ackom-a-o/stm32f446-development-board/README.md

# STM32F446 Development Board

A custom, USB-powered development board for sensor and control experiments, built around the **STM32F446ZET6**. This project follows an embedded hardware design from component selection and PCB layout through assembly preparation, firmware and bench validation.

**Current milestone: prototype fabrication preparation.** The corrected design, fabrication exports and assembly data are published below. Hardware is not yet bench-tested; final assembler production-file approval and physical validation remain open.

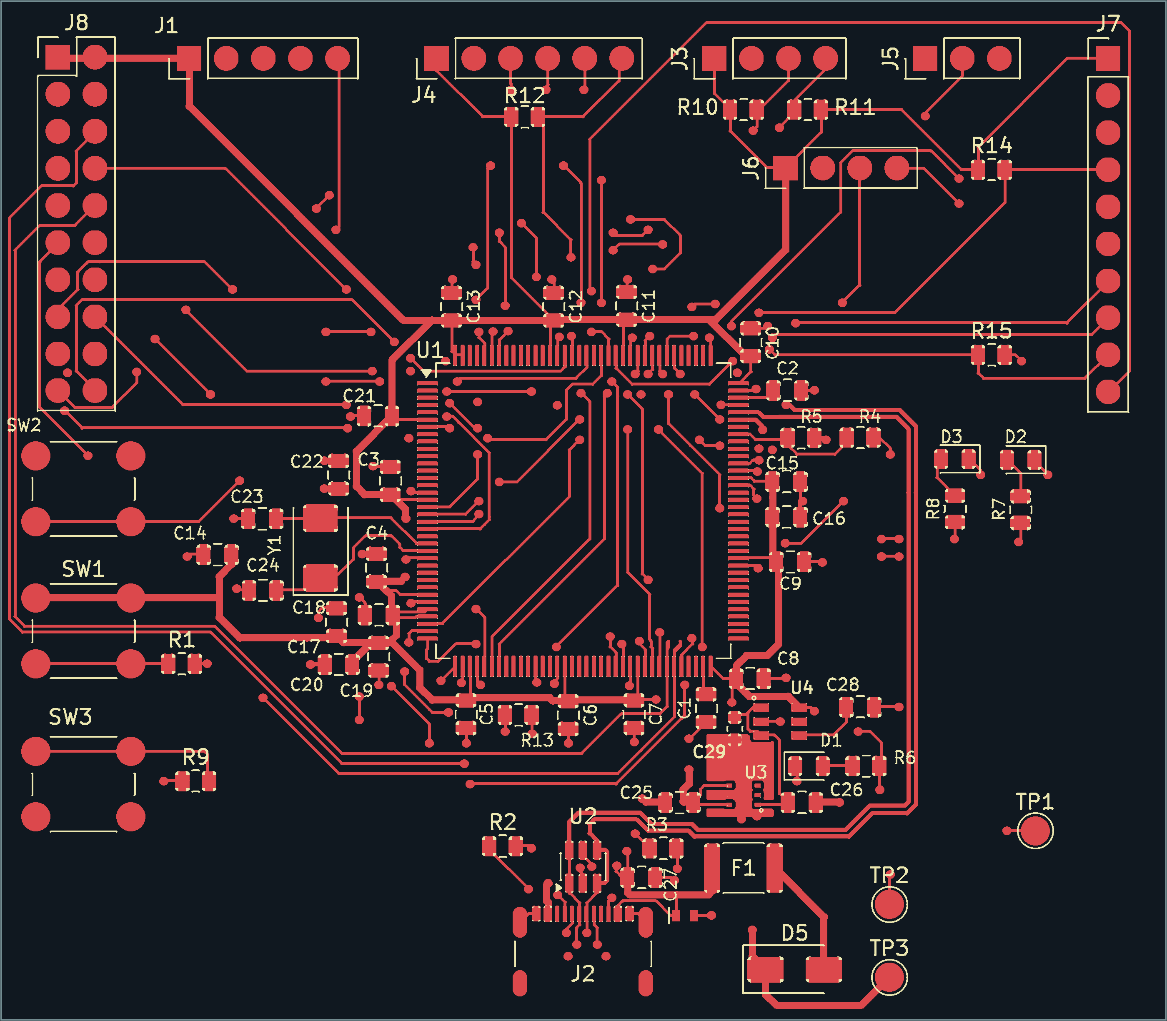
[picture p1: docs/images/pcb-top.png]
Current PCB top copper and silkscreen


*Composed from the current fabrication Gerbers. Top copper and silkscreen only; drill holes are not depicted. This is a design view, not an assembled-board photograph.*

[Schematic PDF](docs/schematic.pdf) · [Engineering review](docs/engineering-review.md) · [Validation evidence](docs/validation.md) · [Manufacturing package](manufacturing/prototype-r3/) · [First power-up](docs/bring-up.md)

## What the board provides

| Area | Implementation |
|---|---|
| MCU | STM32F446ZET6, Arm Cortex-M4, LQFP-144 |
| PCB | 80 × 70 mm, four copper layers, nominal 1.6 mm |
| Power | USB 5 V → protection → TPS7A2533 regulator → TPS22918 load switch → 3.3 V |
| Connectivity | USB 2.0 full-speed device, SPI, I²C, UART, analog and GPIO headers |
| CAN expansion | Classical CAN 2.0B on J7: PD0/RX and PD1/TX; requires an external 3.3 V logic-compatible transceiver |
| Debug | External SWD probe through a custom five-pin header |
| Clock | 8 MHz crystal |
| User controls | Three pushbuttons and three indicator LEDs |

USB host operation, USB Power Delivery and motor-power delivery are outside the current scope. The load switch controls rail startup; it is not a programmable current limiter.

```mermaid
flowchart LR
    USB[USB-C 5 V] --> Protection[Fuse and series diode]
    Protection --> LDO[TPS7A2533 regulator]
    LDO --> Switch[TPS22918 load switch]
    Switch --> Rail[3.3 V MCU and headers]
    Host[USB host data] <--> ESD[USBLC6 protection]
    ESD <--> MCU[STM32F446]
    Probe[External SWD probe] <--> MCU
    MCU <--> IO[SPI / I2C / UART / GPIO]
    MCU <--> CANHeader[J7: PD0 RX / PD1 TX]
    CANHeader <--> Transceiver[External CAN transceiver - required]
    Transceiver <--> CANBus[CANH / CANL bus]
```

CAN uses the MCU's existing CAN1 controller through J7 pin 3 (PD0/CAN1_RX) and pin 4 (PD1/CAN1_TX), configured as AF9. The transceiver and bus termination are external to this PCB. This is Classical CAN, not CAN FD, and firmware/link testing is pending.

## Engineering work behind the layout

The layout was reviewed against MCU and power-component datasheets, ST's USB hardware guidance and published signal-integrity advice. Checks covered electrical connectivity, local bypassing, ground return paths, USB geometry, reset/crystal placement, sourcing, footprint fit and assembly orientation. The [engineering review](docs/engineering-review.md) records the reasoning, corrections, references and remaining limits.

- **Reset routing:** moving C22 reduced its MCU reset route from **19.45 mm to 13.41 mm**, about 31%. The [before/after comparison](docs/design-decisions.md#reset-layout-iteration) records the improvement and remaining compromise.
- **Power margin:** a **250 mA total design budget** was screened against regulator dropout and dissipation. It remains conditional until load and thermal measurements establish the board's operating envelope.
- **Local bypassing:** C29 adds a dedicated 1 µF capacitor at the TPS22918 input instead of relying only on the regulator's more distant output capacitor.
- **Ground return:** a short PG9 inner-layer crossing was moved to the top layer to restore local ground beneath SWDIO. Ground stitching was retained; a geometric screen found no missing reference samples along the checked outer-layer routes.
- **Routing corners:** the remaining ordinary PF6 right-angle bend was replaced with chamfered routing. The saved-board audit found zero ordinary track-to-track 90° bends within its stated scope. [Why prefer 45° bends?](docs/engineering-review.md#routing-corners-why-prefer-45-degrees) They reduce abrupt geometry changes; a right angle alone does not prove a signal will fail.
- **Assembly data:** the supplier preview exposed header and chip rotation mismatches. Corrections were put into the placement file, uploaded and checked after a full quote reload.

Peer feedback and AI-assisted checks supported these iterations. Bench measurements will be reported separately from calculations and software checks.

## Evidence and next milestone

Recorded checks on **22 October 2026** report **0 ERC issues, 0 DRC violations, 0 unconnected items and 0 schematic parity issues**, with no ignored checks or current exclusions. The published inventory contains **66 assembly references**, plus three PCB test points. [Validation evidence](docs/validation.md) links the source hashes, reports and geometric checks; these do not establish measured hardware performance.

The fabricator has confirmed the nominal **JLC04161H-7628** construction used as the design basis. Next: approve final production files and bring up the prototype. The [bring-up checklist](docs/bring-up.md) starts with inspection, shorts and power rails, then SWD/reset, clock startup, GPIO and USB. Every physical test in the [test log](docs/test-log.md) remains **not tested**. Firmware will be added when implementation begins.

## Explore the design

Open [`stm32.kicad_pro`](stm32.kicad_pro) in **KiCad 10**, with its standard libraries installed.

The [four-sheet schematic](docs/schematic.pdf) separates power, USB/debug/clock, peripheral interfaces and expansion. The MCU uses eight symbol units so that supply pins and GPIO ports can be reviewed separately. Named signals connect sheets; pin numbers retain their physical package mapping.

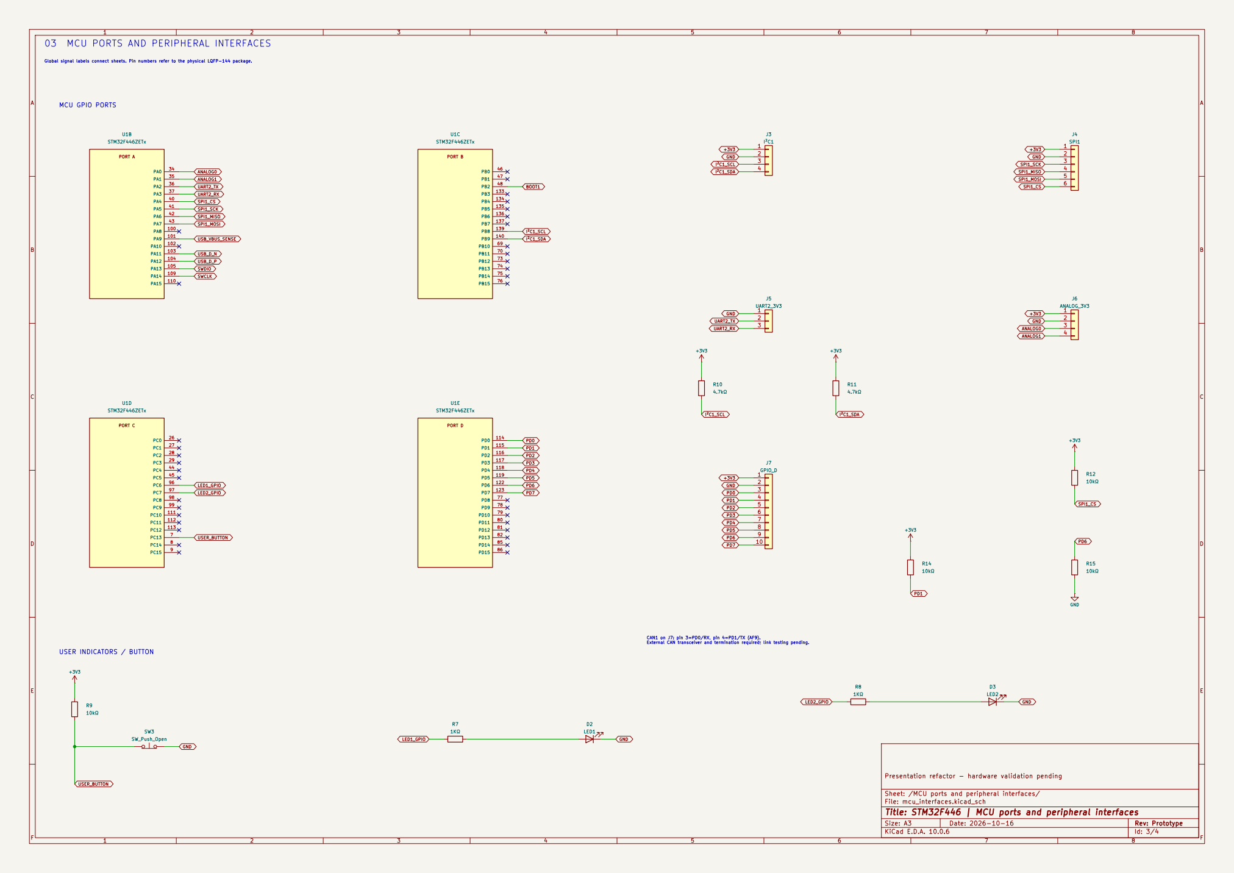
[picture p2: docs/images/schematic-interfaces.png]
MCU ports and peripheral interface schematic


*Sheet 3 of 4. The earlier readability refactor preserved its then-current 68 physical references and all 135 nets; [historical comparison evidence](docs/checks/schematic-refactor.json) records unchanged PCB geometry for that refactor. The subsequent C29 addition brings the current physical-reference count to 69.*

| Files | Purpose |
|---|---|
| `stm32.kicad_sch` | Root sheet: power path and MCU supplies |
| `usb_debug_clock.kicad_sch` | USB, clock, reset, boot and SWD |
| `mcu_interfaces.kicad_sch`, `gpio_expansion.kicad_sch` | MCU ports, peripheral headers and expansion |
| `stm32.kicad_pcb` | Routed four-layer PCB |
| `stm32.kicad_dru` | Project design rules |
| `STM32_Custom.pretty`, `STM32_Power.kicad_sym`, `STM32_MCU.kicad_sym` | Local footprints, power symbols and split MCU symbol |
| `fp-lib-table`, `sym-lib-table` | Project-relative library configuration |
| `docs/` | Schematic export, design decisions, part inventory and validation evidence |

Local libraries are included. The empty `Library.pretty` directory is retained for the existing project library table. The [prototype-r3 package](manufacturing/prototype-r3/) contains Gerbers/drills, BOM, supplier-adjusted placement data and file hashes. It is an unvalidated prototype package, not a production-qualified release. Placement rotations are supplier-specific; another assembler must check its own conventions.

## References and licensing

[STM32F446 datasheet](https://www.st.com/resource/en/datasheet/stm32f446ze.pdf) · [TPS7A25 datasheet](https://www.ti.com/lit/ds/symlink/tps7a25.pdf) · [TPS22918 datasheet](https://www.ti.com/lit/ds/symlink/tps22918.pdf)

A project hardware/documentation license has not yet been selected. No explicit open-source license is currently granted. Third-party assets remain subject to their respective licenses.
