ackom-a-o/stm32f446-development-board/manufacturing/prototype-r3/BOM.csv

Comment | Designator | Footprint | LCSC Part #
2.2uF | C1 | Capacitor_SMD:C_0805_2012Metric | C16195008
2.2uF | C2 | Capacitor_SMD:C_0805_2012Metric | C16195008
100nF | C3 | Capacitor_SMD:C_0805_2012Metric | C49678
100nF | C4 | Capacitor_SMD:C_0805_2012Metric | C49678
100nF | C5 | Capacitor_SMD:C_0805_2012Metric | C49678
100nF | C6 | Capacitor_SMD:C_0805_2012Metric | C49678
100nF | C7 | Capacitor_SMD:C_0805_2012Metric | C49678
100nF | C8 | Capacitor_SMD:C_0805_2012Metric | C49678
100nF | C9 | Capacitor_SMD:C_0805_2012Metric | C49678
100nF | C10 | Capacitor_SMD:C_0805_2012Metric | C49678
100nF | C11 | Capacitor_SMD:C_0805_2012Metric | C49678
100nF | C12 | Capacitor_SMD:C_0805_2012Metric | C49678
100nF | C13 | Capacitor_SMD:C_0805_2012Metric | C49678
4.7uF | C14 | Capacitor_SMD:C_0805_2012Metric | C1779
100nF | C15 | Capacitor_SMD:C_0805_2012Metric | C49678
1µF | C16 | Capacitor_SMD:C_0805_2012Metric | C28323
100nF | C17 | Capacitor_SMD:C_0805_2012Metric | C49678
1µF | C18 | Capacitor_SMD:C_0805_2012Metric | C28323
100nF | C19 | Capacitor_SMD:C_0805_2012Metric | C49678
1µF | C20 | Capacitor_SMD:C_0805_2012Metric | C28323
100nF | C21 | Capacitor_SMD:C_0805_2012Metric | C49678
100nF | C22 | Capacitor_SMD:C_0805_2012Metric | C49678
22pF C0G | C23 | Capacitor_SMD:C_0805_2012Metric | C1804
22pF C0G | C24 | Capacitor_SMD:C_0805_2012Metric | C1804
2.2uF25VX7R | C25 | Capacitor_SMD:C_0805_2012Metric | C16195008
2.2uF 25V X7R | C26 | Capacitor_SMD:C_0805_2012Metric | C16195008
100nF | C27 | Capacitor_SMD:C_0805_2012Metric | C49678
4.7nF | C28 | Capacitor_SMD:C_0805_2012Metric | C107153
1µF | C29 | Capacitor_SMD:C_0603_1608Metric | C29936
Green | D1 | LED_SMD:LED_0805_2012Metric | C2297
LED1 | D2 | LED_SMD:LED_0805_2012Metric | C2295
LED2 | D3 | LED_SMD:LED_0805_2012Metric | C2295
ESDA7P120-1U1M | D4 | STM32_Custom:ESDA7P60-1U1M | C2969802
SS14 | D5 | Diode_SMD:D_SMA | C2480
500mA | F1 | Fuse:Fuse_1812_4532Metric | C17313
SWD | J1 | Connector_PinHeader_2.54mm:PinHeader_1x05_P2.54mm_Vertical | C55629812
USB_C_Receptacle_USB2.0_16P | J2 | STM32_Custom:USB_C_Receptacle_USB4105_JLC | C5184243
I²C1 | J3 | Connector_PinHeader_2.54mm:PinHeader_1x04_P2.54mm_Vertical | C492403
SPI1 | J4 | Connector_PinHeader_2.54mm:PinHeader_1x06_P2.54mm_Vertical | C5142852
UART2_3V3 | J5 | Connector_PinHeader_2.54mm:PinHeader_1x03_P2.54mm_Vertical | C18213718
ANALOG_3V3 | J6 | Connector_PinHeader_2.54mm:PinHeader_1x04_P2.54mm_Vertical | C492403
GPIO_D | J7 | Connector_PinHeader_2.54mm:PinHeader_1x10_P2.54mm_Vertical | C492409
EXPANSION_3V3 | J8 | Connector_PinHeader_2.54mm:PinHeader_2x10_P2.54mm_Vertical | C492427
10kΩ | R1 | Resistor_SMD:R_0805_2012Metric | C17414
5.1kΩ 1% | R2 | Resistor_SMD:R_0805_2012Metric | C27834
5.1kΩ 1% | R3 | Resistor_SMD:R_0805_2012Metric | C27834
33kΩ,1% | R4 | Resistor_SMD:R_0805_2012Metric | C17633
82kΩ,1% | R5 | Resistor_SMD:R_0805_2012Metric | C17840
1KΩ | R6 | Resistor_SMD:R_0805_2012Metric | C17513
1KΩ | R7 | Resistor_SMD:R_0805_2012Metric | C17513
1KΩ | R8 | Resistor_SMD:R_0805_2012Metric | C17513
10kΩ | R9 | Resistor_SMD:R_0805_2012Metric | C17414
4.7kΩ | R10 | Resistor_SMD:R_0805_2012Metric | C17673
4.7kΩ | R11 | Resistor_SMD:R_0805_2012Metric | C17673
10kΩ | R12 | Resistor_SMD:R_0805_2012Metric | C17414
10kΩ | R13 | Resistor_SMD:R_0805_2012Metric | C17414
10kΩ | R14 | Resistor_SMD:R_0805_2012Metric | C17414
10kΩ | R15 | Resistor_SMD:R_0805_2012Metric | C17414
SW_Push_Open | SW1 | Button_Switch_THT:SW_PUSH_6mm_H4.3mm | C93157
SW_Push_Open | SW2 | Button_Switch_THT:SW_PUSH_6mm_H4.3mm | C93157
SW_Push_Open | SW3 | Button_Switch_THT:SW_PUSH_6mm_H4.3mm | C93157
STM32F446ZETx | U1 | Package_QFP:LQFP-144_20x20mm_P0.5mm | C1337227
USBLC6-2SC6 | U2 | Package_TO_SOT_SMD:SOT-23-6 | C7519
TPS7A2533DRVR | U3 | STM32_Custom:TPS7A25_DRV0006A | C2867820
TPS22918DBVR | U4 | STM32_Custom:TPS22918_DBV0006A | C131941
8MHz | Y1 | Crystal:Crystal_SMD_Abracon_ABM3-2Pin_5.0x3.2mm | C2450458
