ackom-a-o/stm32f446-development-board/docs/test-log.md

# Prototype test log

No hardware tests have been completed yet. Do not interpret the planned checks below as passing results.

Use the [first power-up checklist](bring-up.md) for the intended sequence and the [validation page](validation.md) for completed software/design checks.

Record the board revision, instruments, supply settings, firmware commit and ambient conditions with each test. Add photographs or measurements when available, and record failures as well as fixes.

| Test | Purpose | Result | Evidence |
|---|---|---|---|
| Assembly inspection | Check soldering, orientation and connector seating | Not tested | — |
| Unpowered checks | Check for unexpected rail-to-ground shorts before power | Not tested | — |
| Controlled first power-up | Check input current and rail voltages using the reviewed power path | Not tested | — |
| Power and thermal loading | Establish usable load and temperature behaviour | Not tested | — |
| SWD and reset | Establish reliable debug access and reset | Not tested | — |
| Clock startup | Verify oscillator operation and firmware clock configuration | Not tested | — |
| GPIO and user controls | Exercise LEDs, buttons and selected headers | Not tested | — |
| USB device operation | Test enumeration and data transfer | Not tested | — |

## Test entry template

Copy this section for each bench session:

- Date:
- Board revision and unit:
- Firmware commit:
- Instruments and connections:
- Supply voltage and current limit:
- Expected behaviour and acceptance criteria:
- Measurements and observations:
- Pass / fail / inconclusive:
- Follow-up action:
- Evidence files:
