ackom-a-o/stm32f446-development-board/docs/schematic.pdf

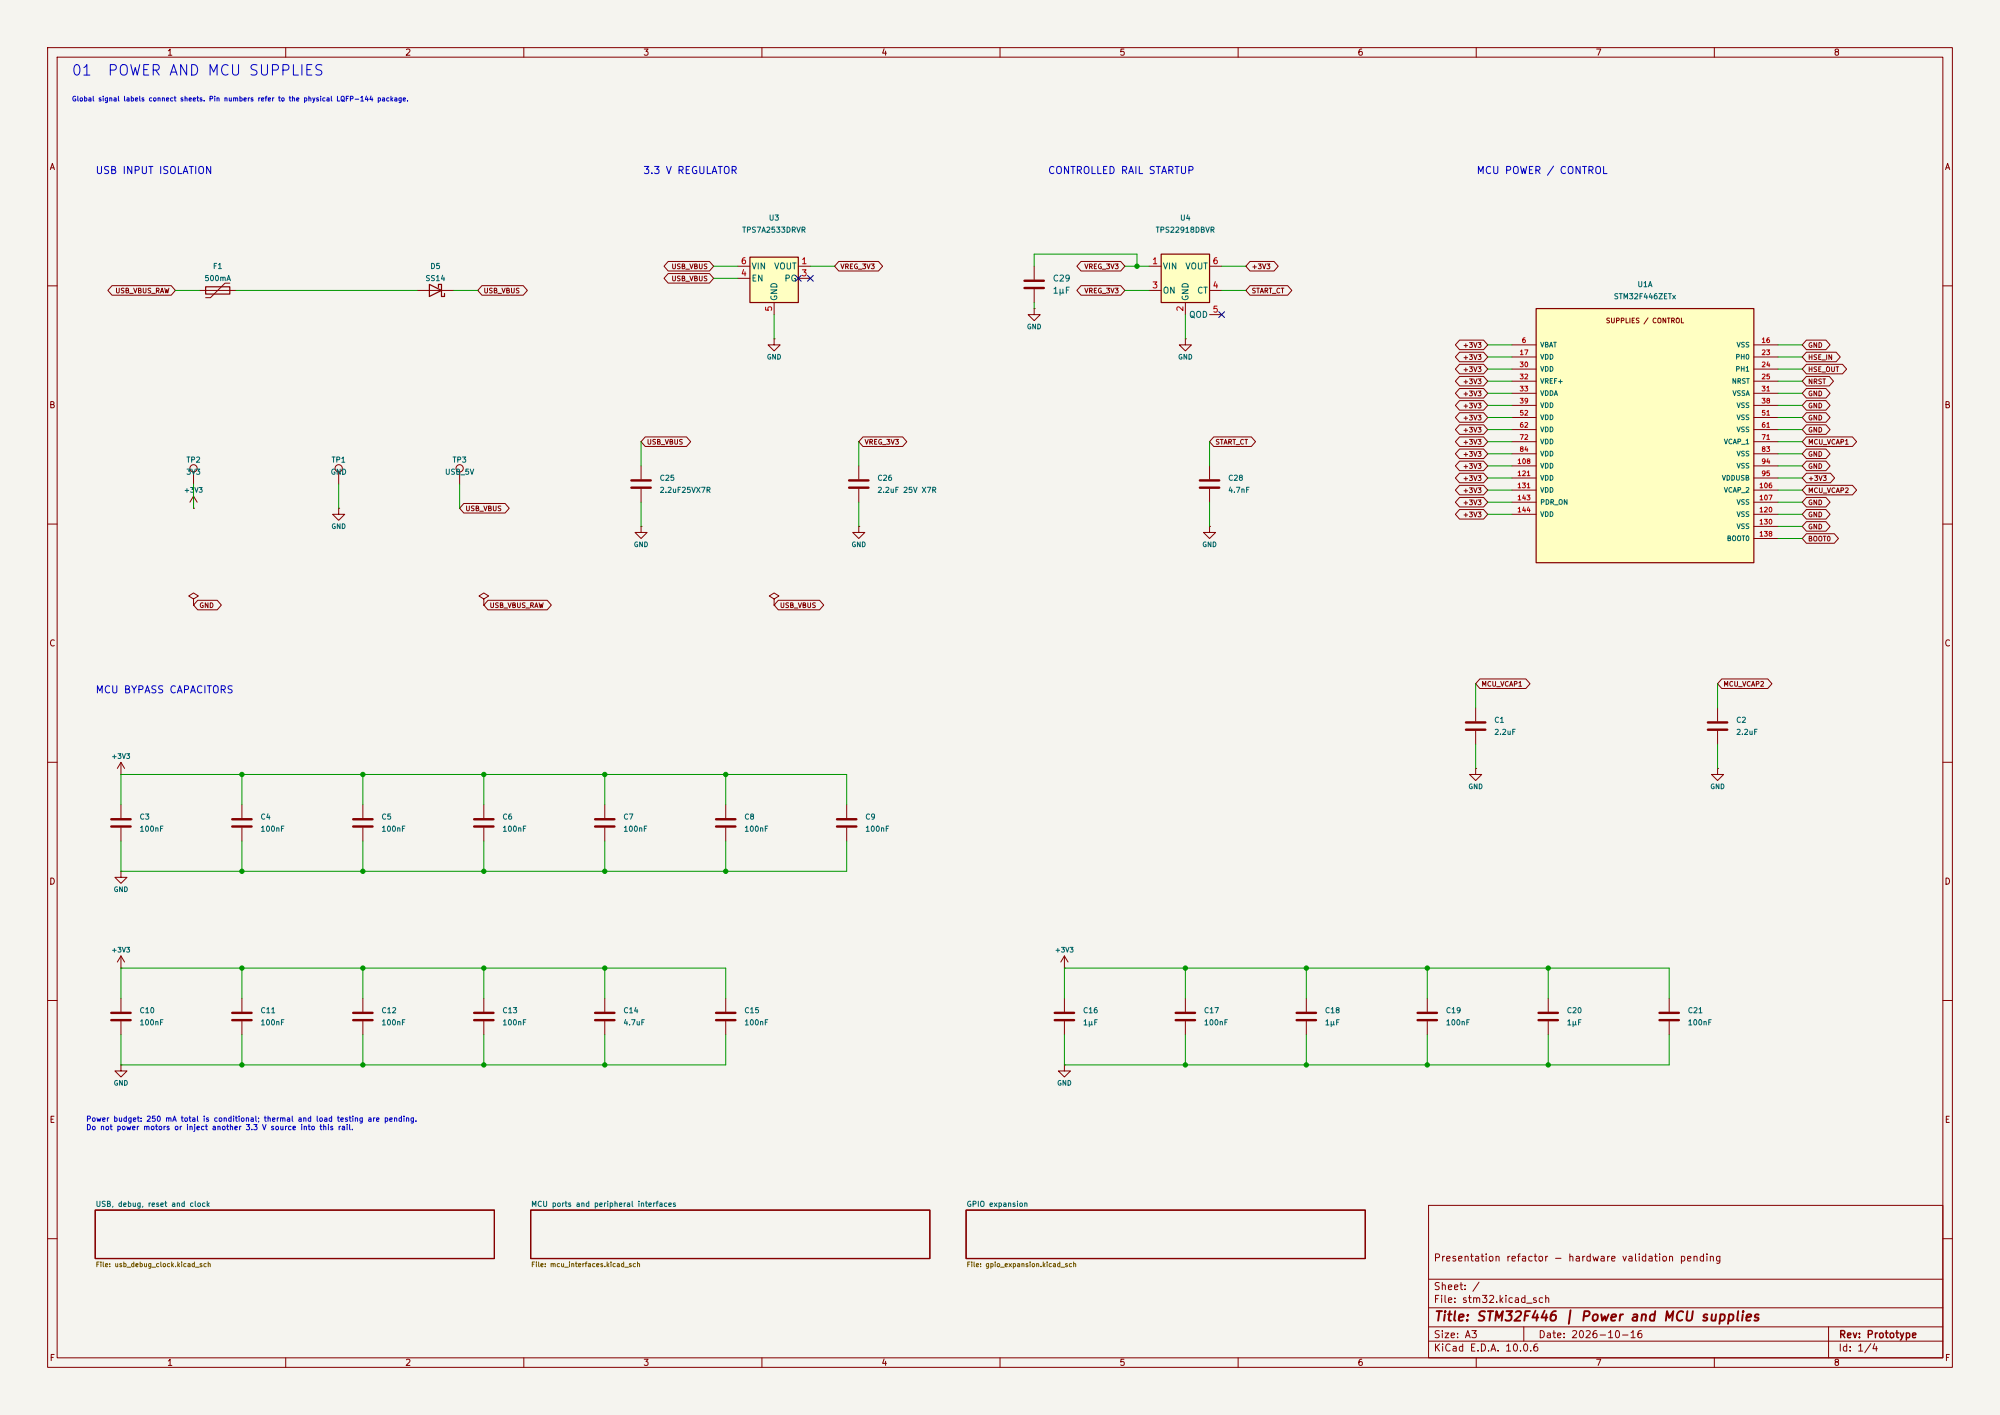
[picture p5: page 1]

01 POWER AND MCU SUPPLIES

Power budget: 250 mA total is conditional; thermal and load testing are pending. Do not power motors or inject another 3.3 V source into this rail.

USB, debug, reset and clock

File: gpio_expansion.kicad_sch MCU ports and peripheral interfaces

Presentation refactor - hardware validation pending

Sheet: /
File: stm32.kicad_sch
Title: STM32F446 | Power and MCU supplies

Size: A3 | Rev: Prototype | F Date: 2026-10-16
KiCad E.D.A. 10.0.6 | Id: 1/4

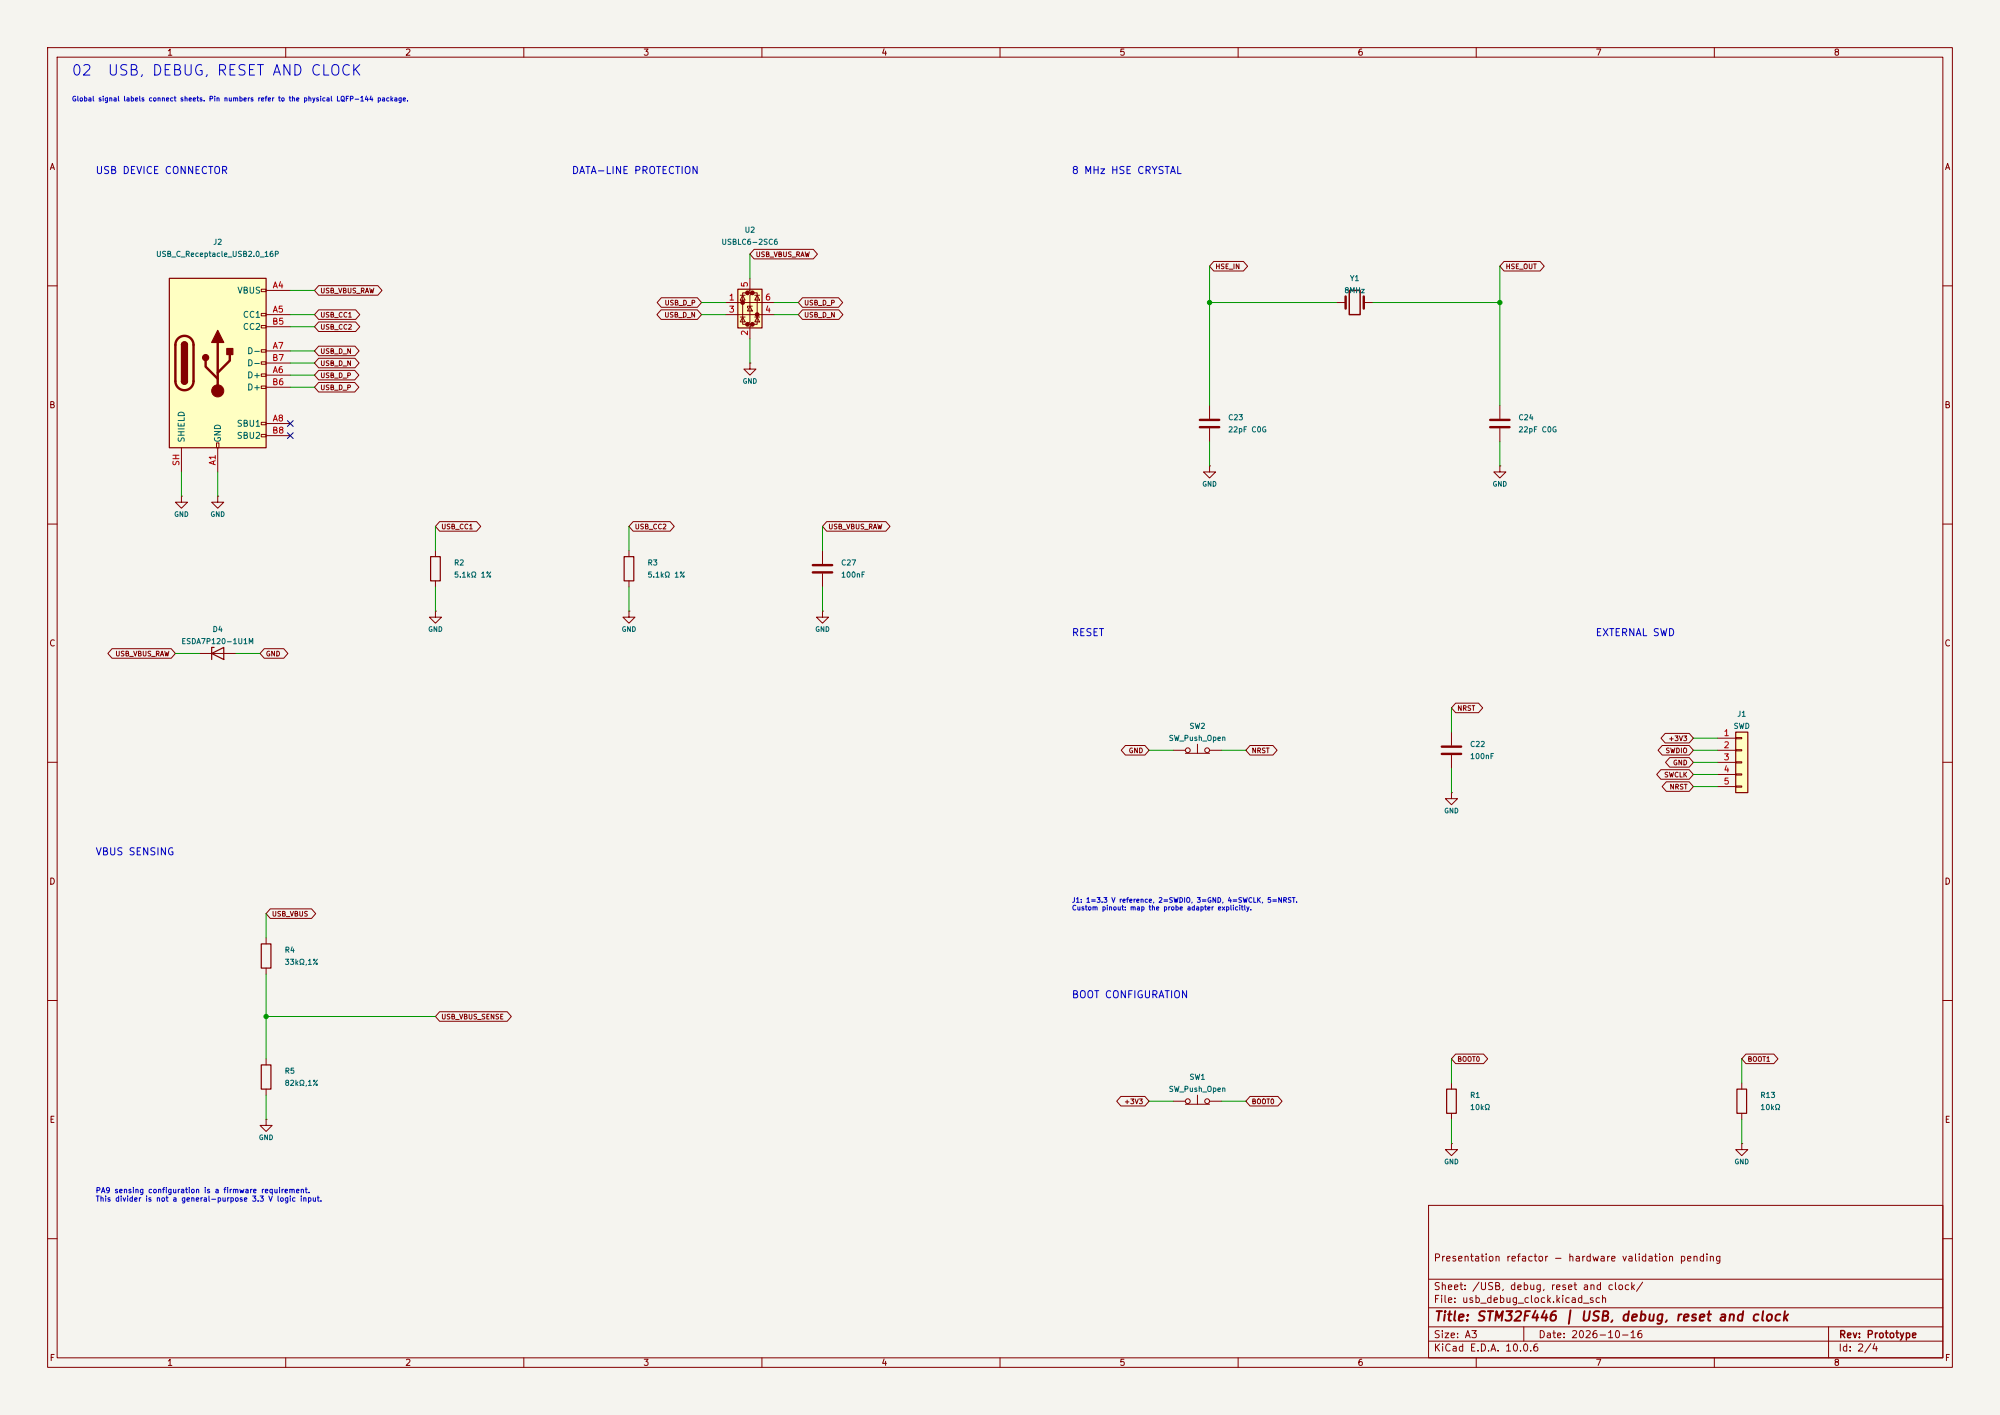
[picture p6: page 2]

02 USB, DEBUG, RESET AND CLOCK

Global signal labels connect sheets. Pin numbers refer to the physical LQFP-144 package. USB DEVICE CONNECTOR

SWDIO +3V3 NRST VBUS SENSING

J1: 1=3.3 V reference, 2=SWDIO, 3=GND, 4=SWCLK, 5=NRST. Custom pinout: map the probe adapter explicitly.

PA9 sensing configuration is a firmware requirement. This divider is not a general-purpose 3.3 V logic input.

Presentation refactor - hardware validation pending

Sheet: /USB, debug, reset and clock/
File: usb_debug_clock.kicad_sch
Title: STM32F446 | USB, debug, reset and clock

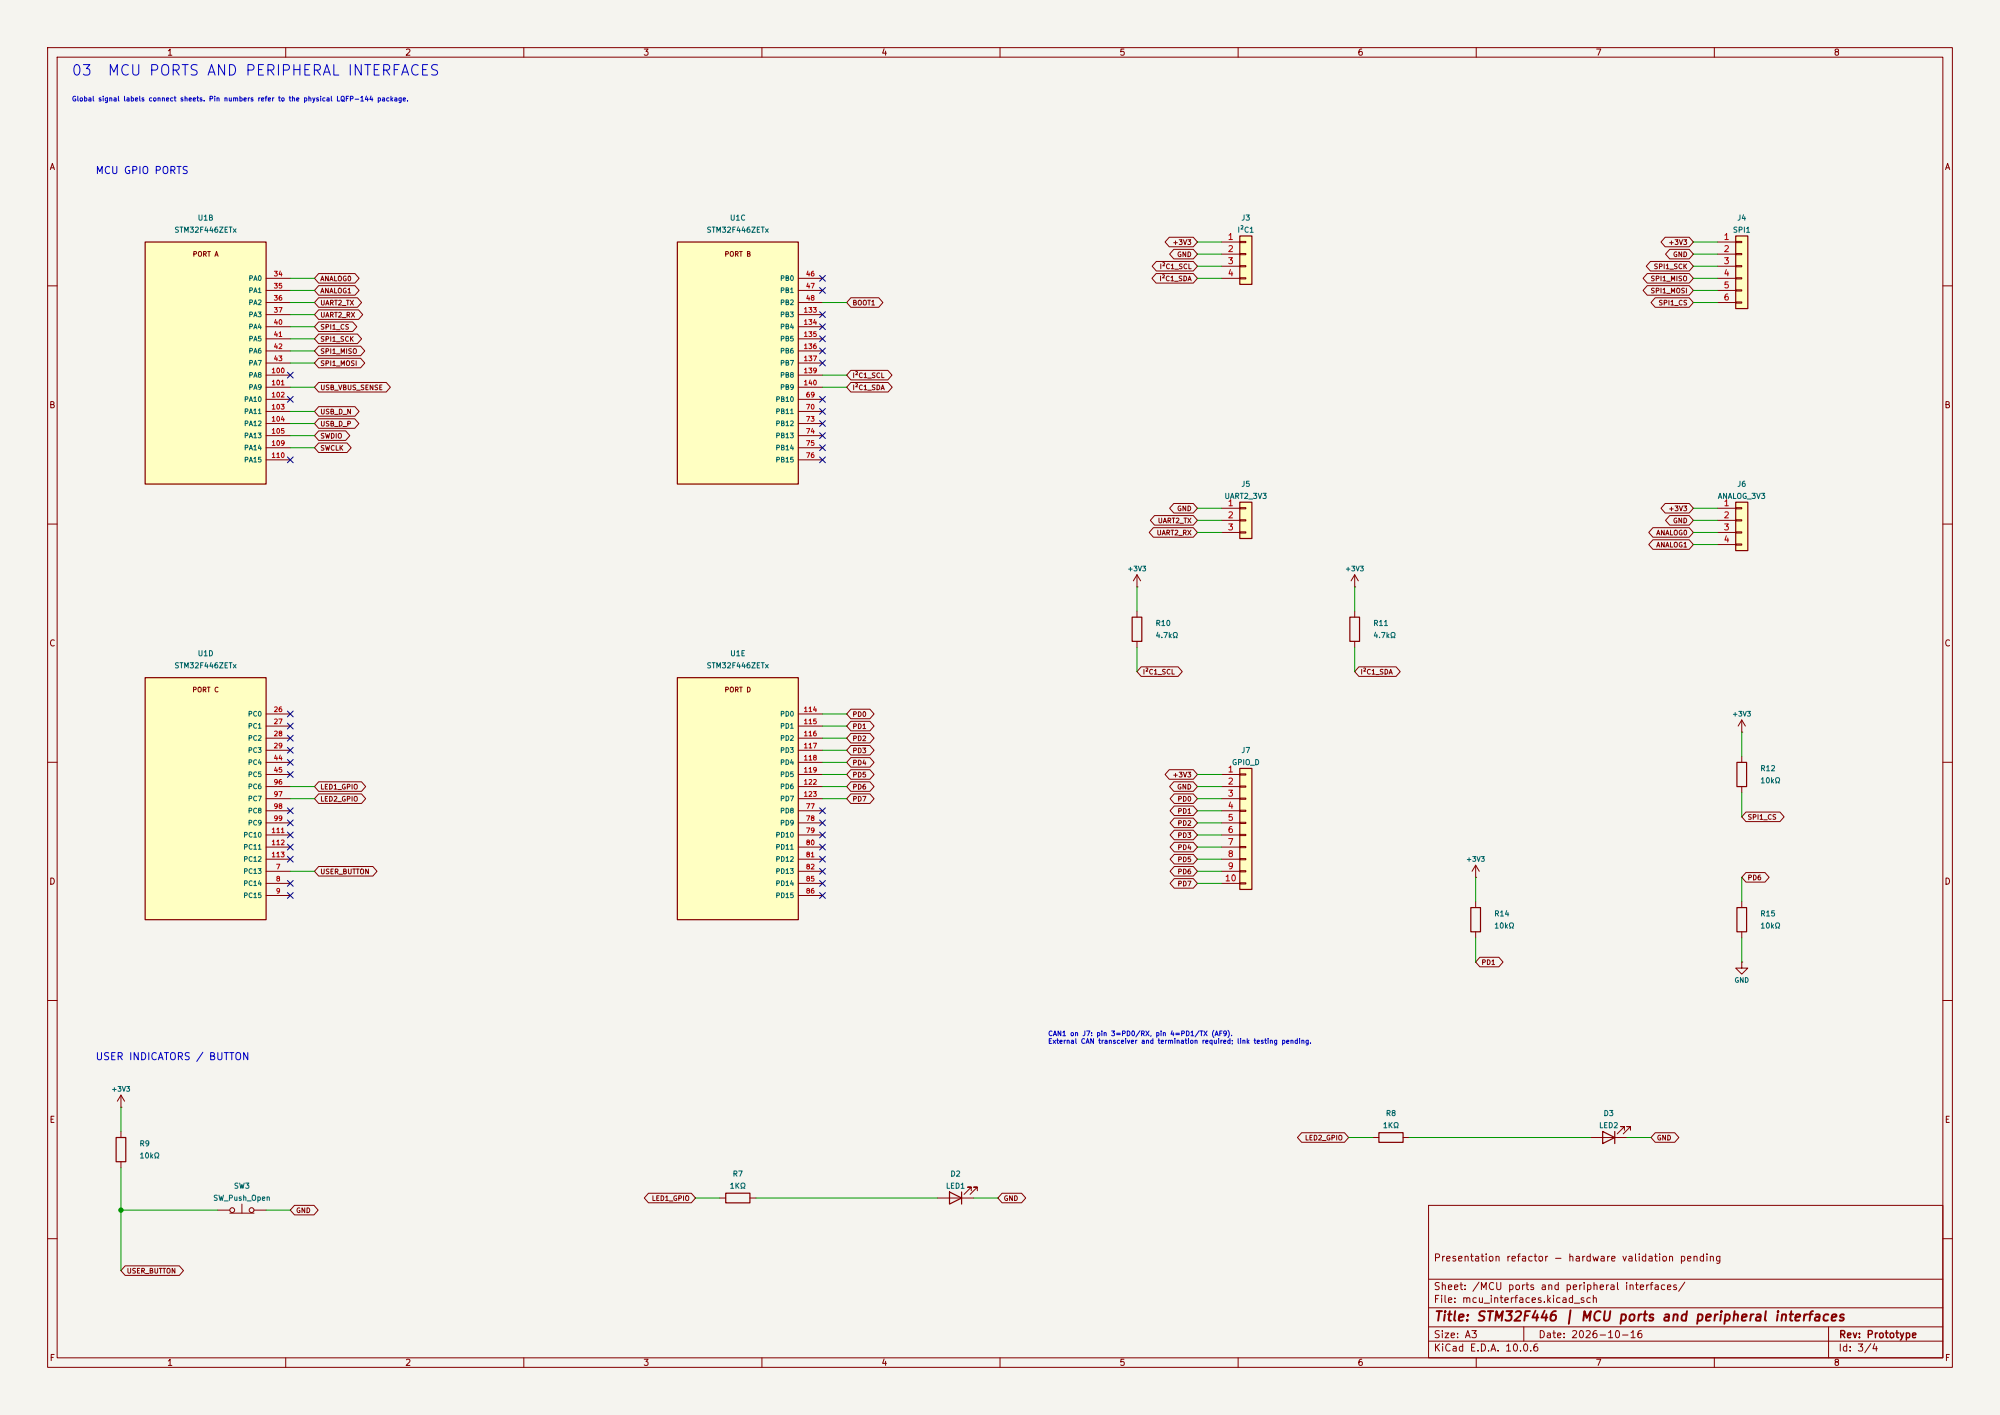
[picture p7: page 3]

03 MCU PORTS AND PERIPHERAL INTERFACES
STM32F446ZETx PORT C

Global signal labels connect sheets. Pin numbers refer to the physical LQFP-144 package. MCU GPIO PORTS

CAN1 on J7: pin 3=PD0/RX, pin 4=PD1/TX (AF9). External CAN transceiver and termination required; link testing pending.

Presentation refactor - hardware validation pending

Sheet: /MCU ports and peripheral interfaces/
File: mcu_interfaces.kicad_sch
Title: STM32F446 | MCU ports and peripheral interfaces

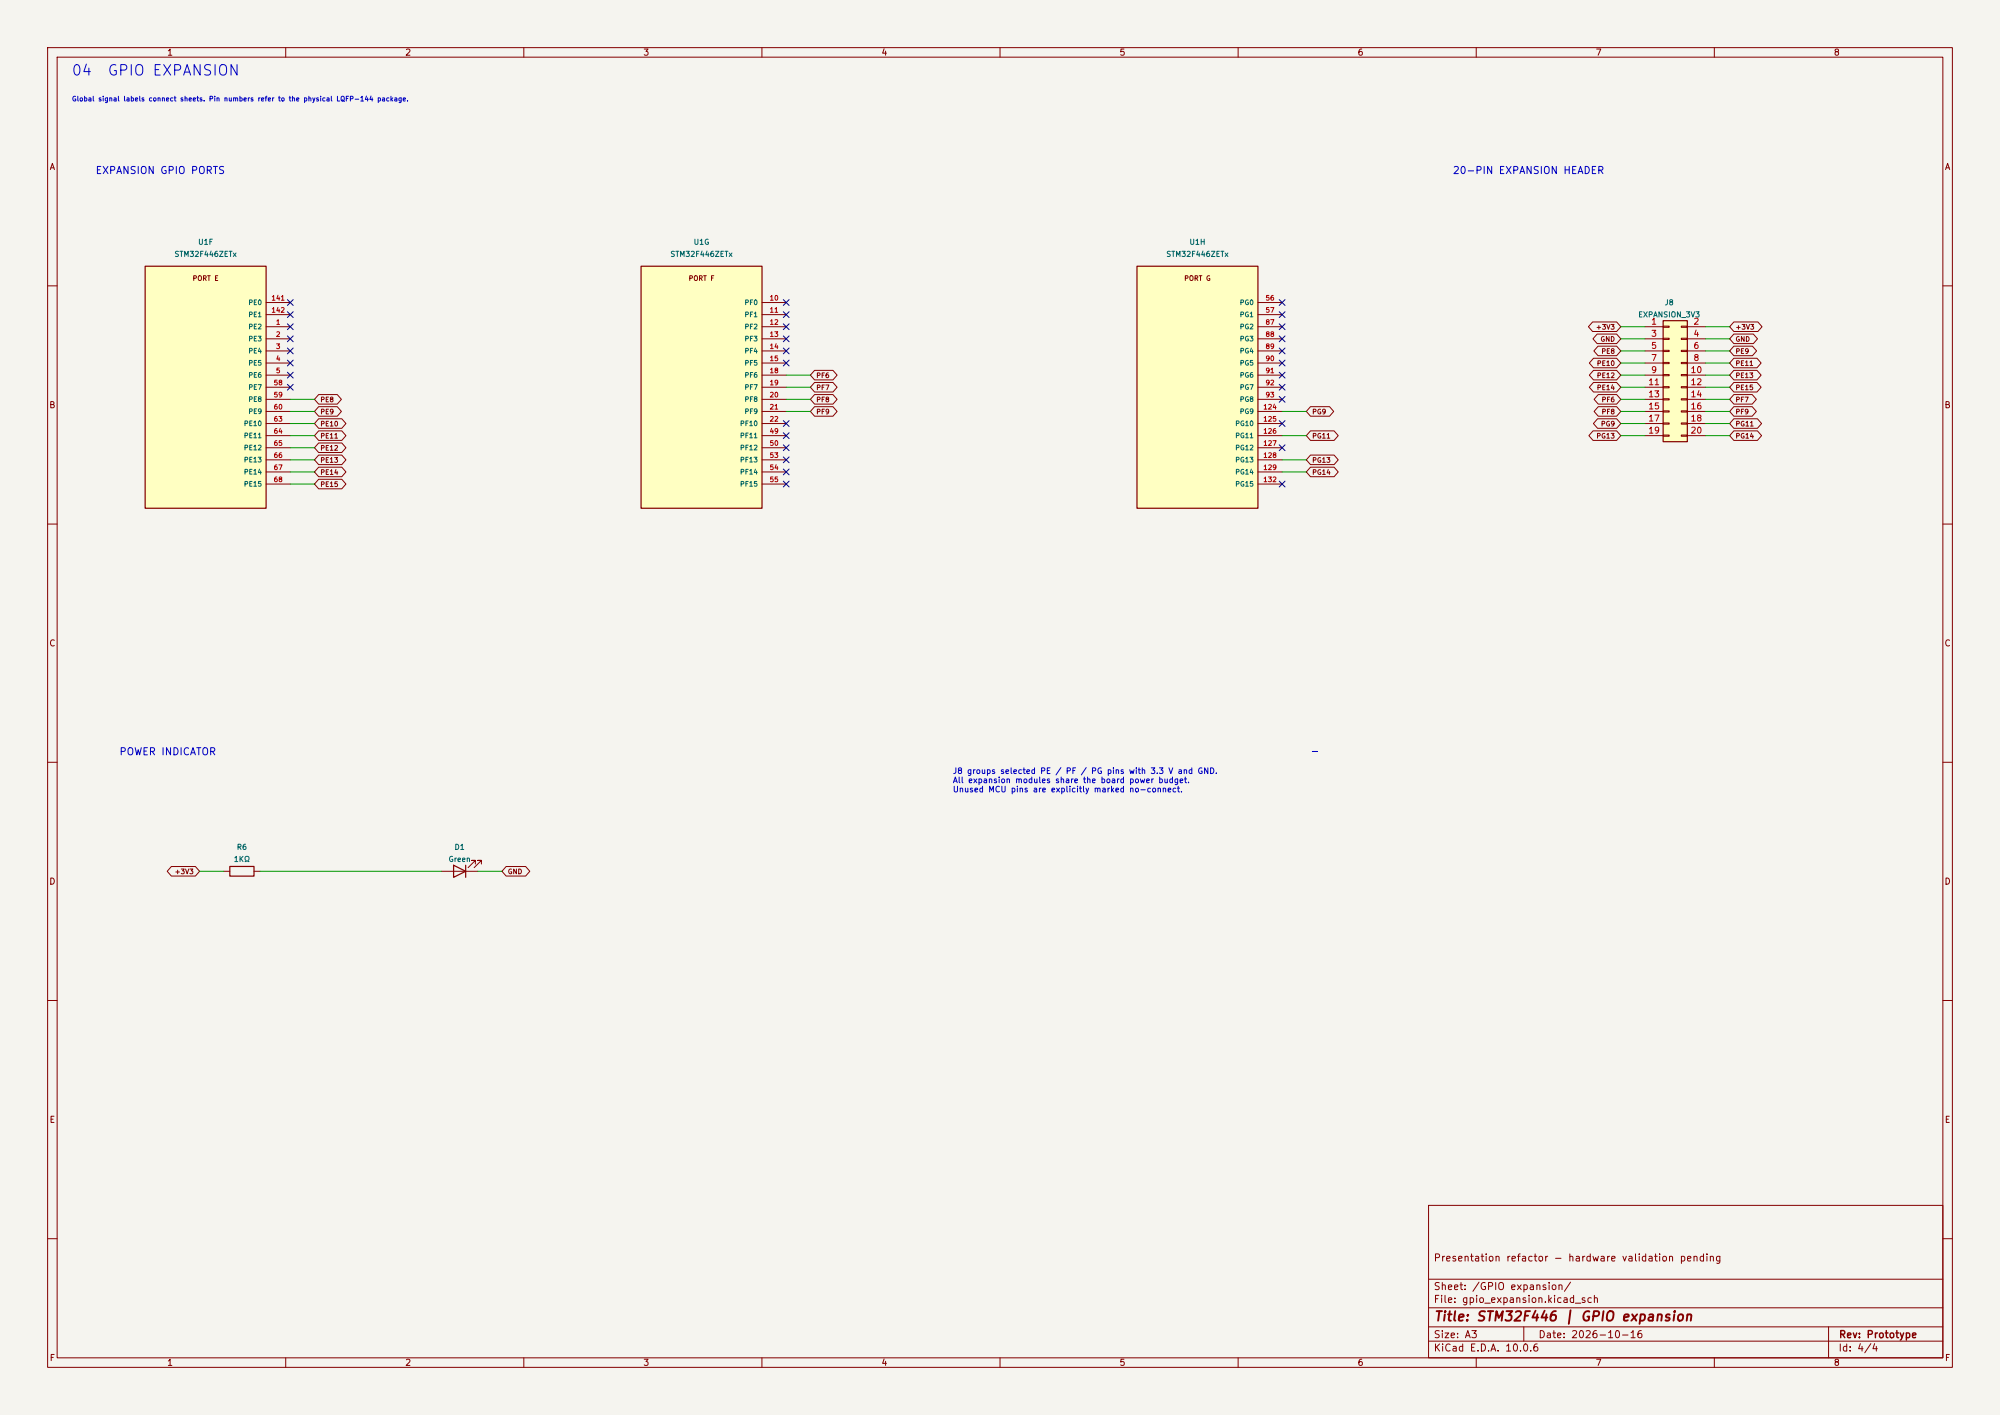
[picture p8: page 4]

Global signal labels connect sheets. Pin numbers refer to the physical LQFP-144 package.

J8 groups selected PE / PF / PG pins with 3.3 V and GND. All expansion modules share the board power budget. Unused MCU pins are explicitly marked no-connect.

Presentation refactor - hardware validation pending
