ackom-a-o/stm32f446-development-board/(list of files, drawings)

Other design files:
docs/checks/schematic-refactor.json
