ackom-a-o/stm32f446-development-board/stm32.kicad_pcb

## KiCad design stm32.kicad_pcb (2026-10-22)

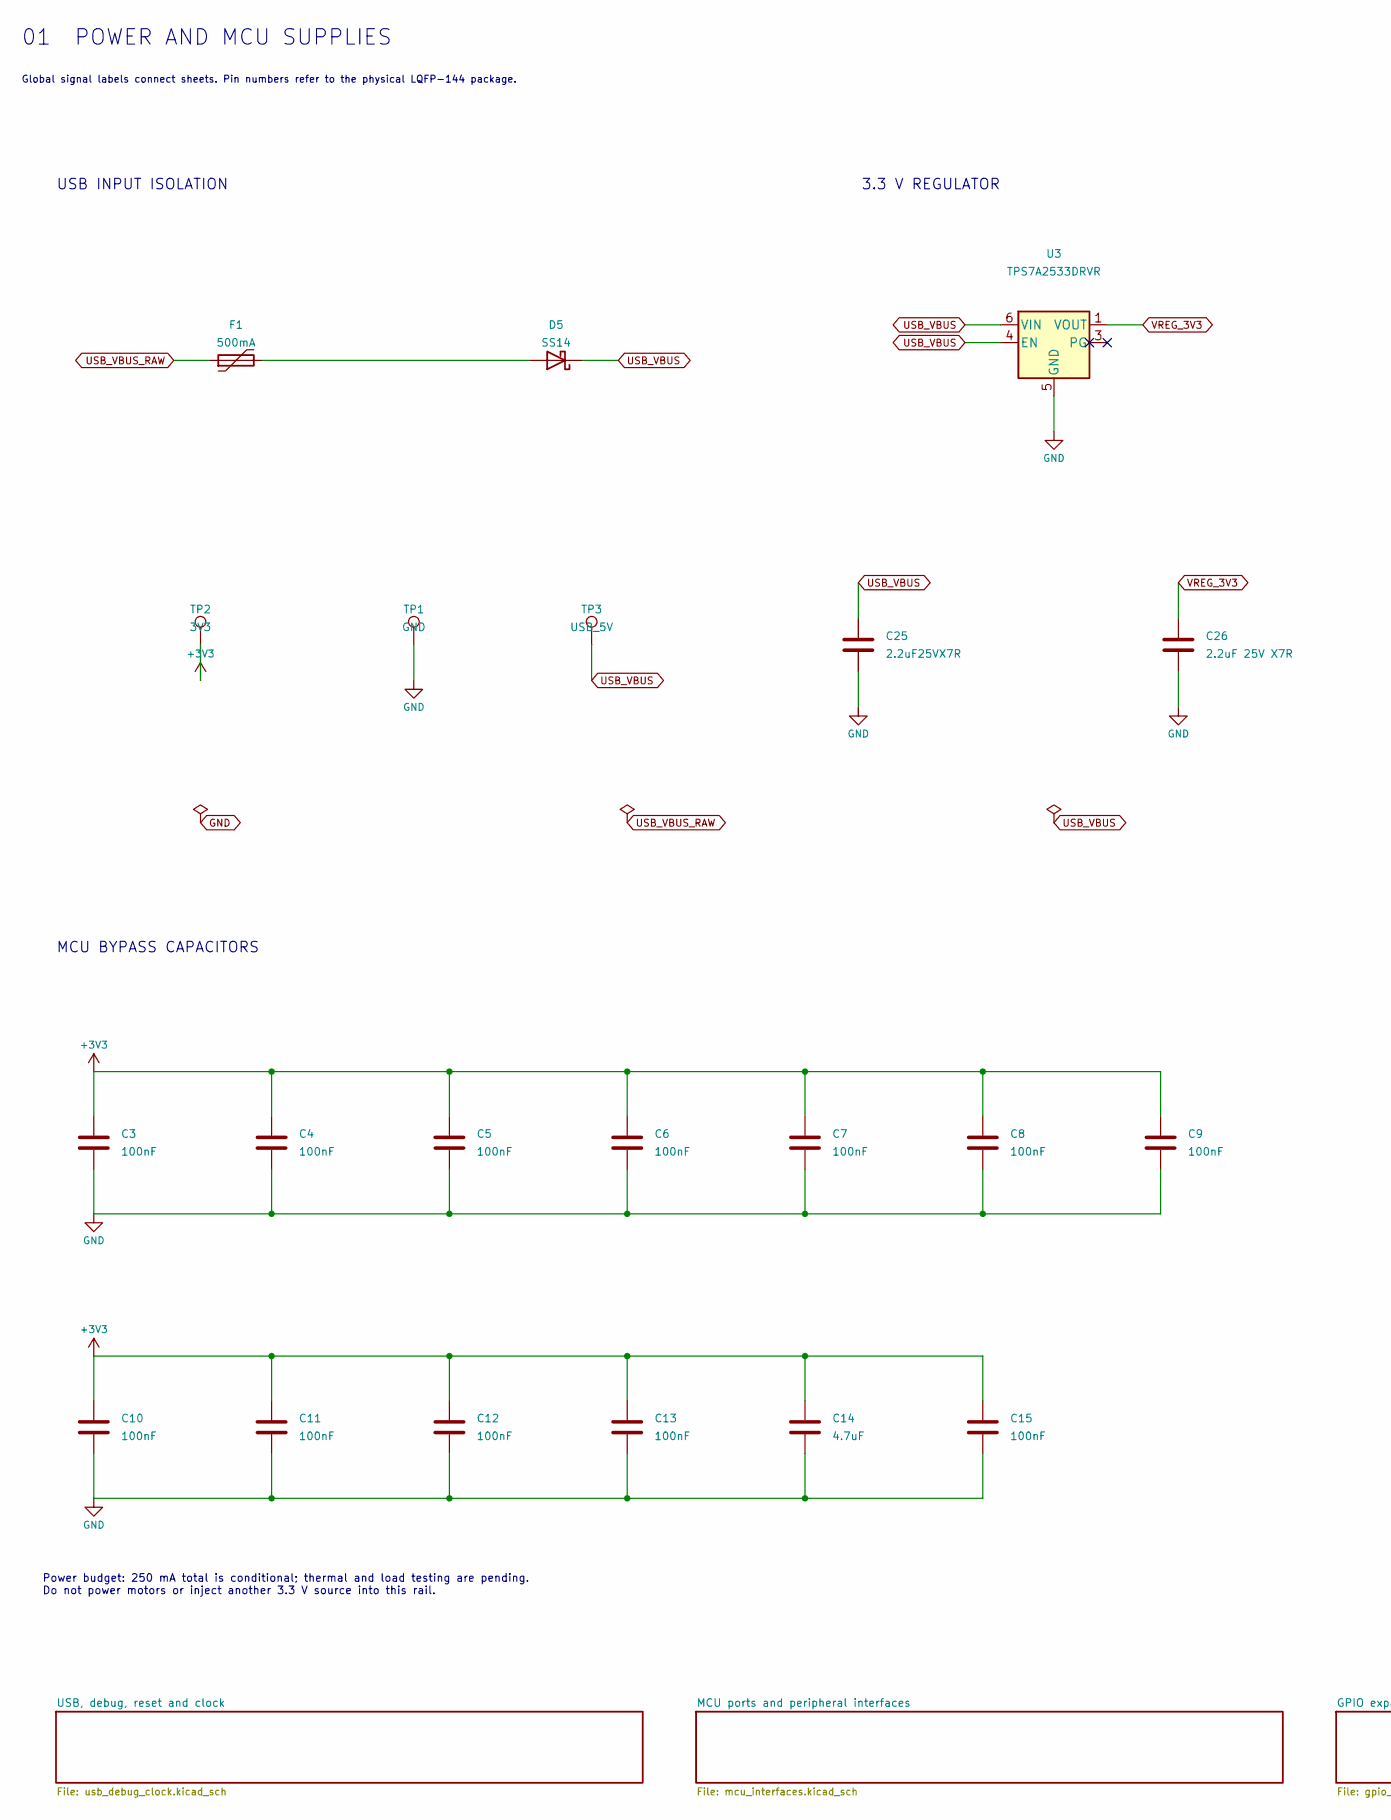
[picture p9: schematic stm32.kicad_sch, STM32F446 | Power and MCU supplies, part in row 1, column 1]

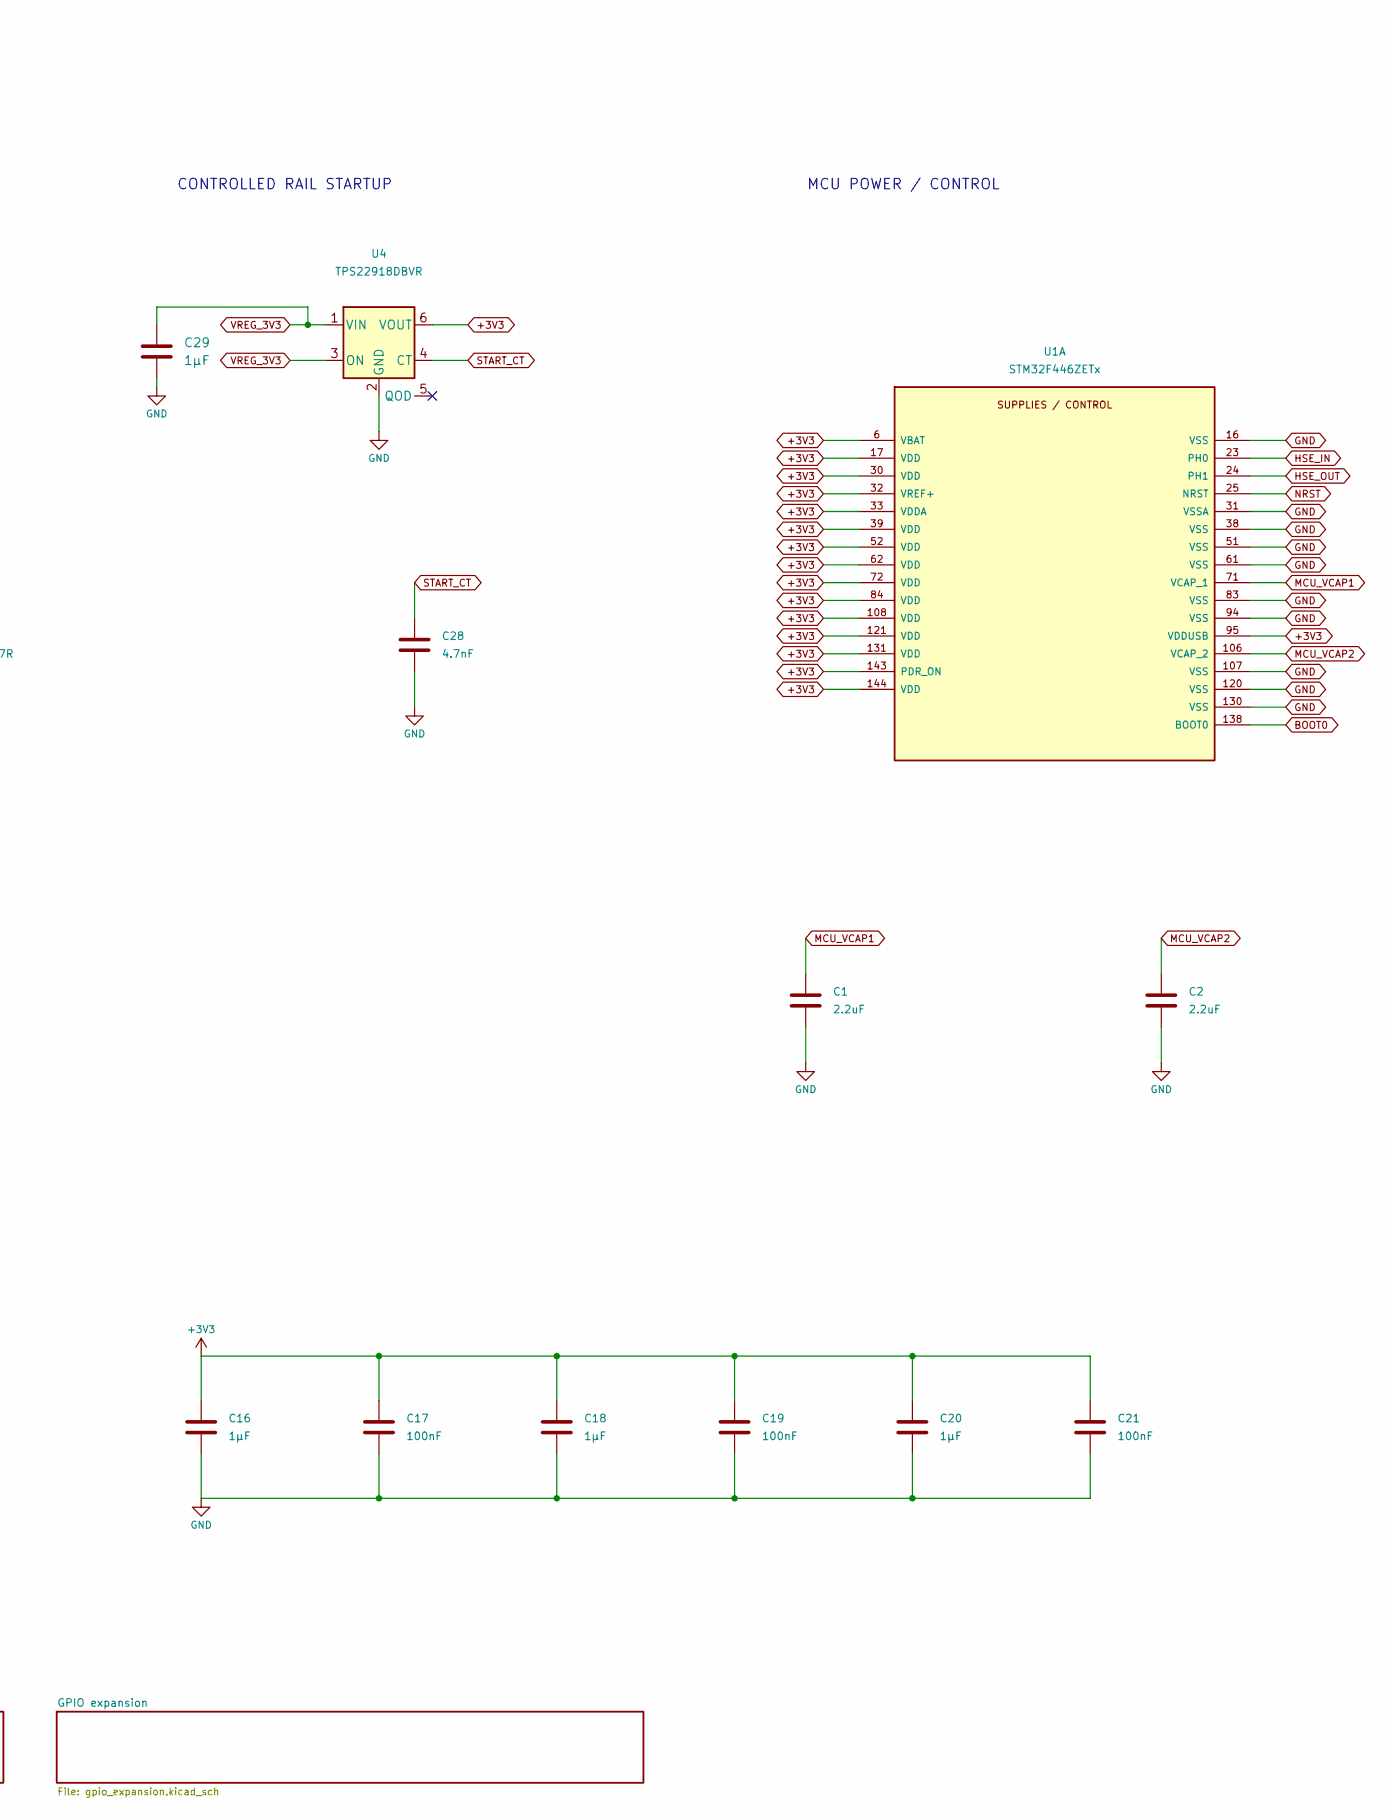
[picture p10: schematic stm32.kicad_sch, STM32F446 | Power and MCU supplies, part in row 1, column 2]

Parts:
C1, C2: 2.2uF; C_0805_2012Metric; Manufacturer Part Number CL21B225KAFVPJE; LCSC Part Number C16195008
C3, C4, C5, C6, C7, C8, C9, C10, C11, C12, C13, C15, C17, C19, C21: 100nF; C_0805_2012Metric; Manufacturer Part Number CC0805KRX7R9BB104; LCSC Part Number C49678
C14: 4.7uF; C_0805_2012Metric; Manufacturer Part Number CL21A475KAQNNNE; LCSC Part Number C1779
C16, C18, C20: 1µF; C_0805_2012Metric; Manufacturer Part Number CL21B105KBFNNNE; LCSC Part Number C28323
C25: 2.2uF25VX7R; C_0805_2012Metric; Manufacturer Part Number CL21B225KAFVPJE; LCSC Part Number C16195008
C26: 2.2uF 25V X7R; C_0805_2012Metric; Manufacturer Part Number CL21B225KAFVPJE; LCSC Part Number C16195008
C28: 4.7nF; C_0805_2012Metric; Manufacturer Part Number CC0805KRX7R9BB472; LCSC Part Number C107153
C29: 1µF; C_0603_1608Metric; Manufacturer Part Number CL10B105KA8NNNC; LCSC Part Number C29936
D5: SS14; D_SMA; Manufacturer Part Number SS14; LCSC Part Number C2480
F1: 500mA; Fuse_1812_4532Metric; Manufacturer Part Number MF-MSMF050-2; LCSC Part Number C17313
TP1: GND; TestPoint_Pad_D2.0mm
TP2: 3V3; TestPoint_Pad_D2.0mm
TP3: USB_5V; TestPoint_Pad_D2.0mm
U1: STM32F446ZETx; LQFP-144_20x20mm_P0.5mm; Manufacturer Part Number STM32F446ZET6; LCSC Part Number C1337227
U3: TPS7A2533DRVR; TPS7A25_DRV0006A; Manufacturer Part Number TPS7A2533DRVR; LCSC Part Number C2867820
U4: TPS22918DBVR; TPS22918_DBV0006A; Manufacturer Part Number TPS22918DBVR; LCSC Part Number C131941

Connections:
+3V3: C3.1, C4.2, C5.1, C6.1, C7.1, C8.1, C9.2, C10.2, C11.2, C12.2, C13.2, C14.1, C15.1, C16.1, C17.2, C18.2, C19.1, C20.1, C21.2, TP2.1 (1_1), U1.6 (VBAT), U1.17 (VDD), U1.30 (VDD), U1.32 (VREF+), U1.33 (VDDA), U1.39 (VDD), U1.52 (VDD), U1.62 (VDD), U1.72 (VDD), U1.84 (VDD), U1.95 (VDDUSB), U1.108 (VDD), U1.121 (VDD), U1.131 (VDD), U1.143 (PDR_ON), U1.144 (VDD), U4.6 (VOUT); also elsewhere on the board
BOOT0: U1.138 (BOOT0); also elsewhere on the board
GND: C1.1, C2.2, C3.2, C4.1, C5.2, C6.2, C7.2, C8.2, C9.1, C10.1, C11.1, C12.1, C13.1, C14.2, C15.2, C16.2, C17.1, C18.1, C19.2, C20.2, C21.1, C25.2, C26.2, C28.2, C29.2, TP1.1 (1_1), U1.16 (VSS), U1.31 (VSSA), U1.38 (VSS), U1.51 (VSS), U1.61 (VSS), U1.83 (VSS), U1.94 (VSS), U1.107 (VSS), U1.120 (VSS), U1.130 (VSS), U3.5 (GND), U3.7 (EP), U4.2 (GND); also elsewhere on the board
HSE_IN: U1.23 (PH0); also elsewhere on the board
HSE_OUT: U1.24 (PH1); also elsewhere on the board
MCU_VCAP1: C1.2, U1.71 (VCAP_1)
MCU_VCAP2: C2.1, U1.106 (VCAP_2)
NRST: U1.25 (NRST); also elsewhere on the board
unnamed: D5.2 (A), F1.2
START_CT: C28.1, U4.4 (CT)
USB_VBUS: C25.1, D5.1 (K), TP3.1 (1_1), U3.4 (EN), U3.6 (VIN); also elsewhere on the board
USB_VBUS_RAW: F1.1; also elsewhere on the board
VREG_3V3: C26.1, C29.1, U3.1 (VOUT), U4.1 (VIN), U4.3 (ON)

Notes on the sheet:
USB INPUT ISOLATION
01 POWER AND MCU SUPPLIES
3.3 V REGULATOR
CONTROLLED RAIL STARTUP
Power budget: 250 mA total is conditional; thermal and load testing are pending. Do not power motors or inject another 3.3 V source into this rail.
MCU POWER / CONTROL
MCU BYPASS CAPACITORS
Global signal labels connect sheets. Pin numbers refer to the physical LQFP-144 package.

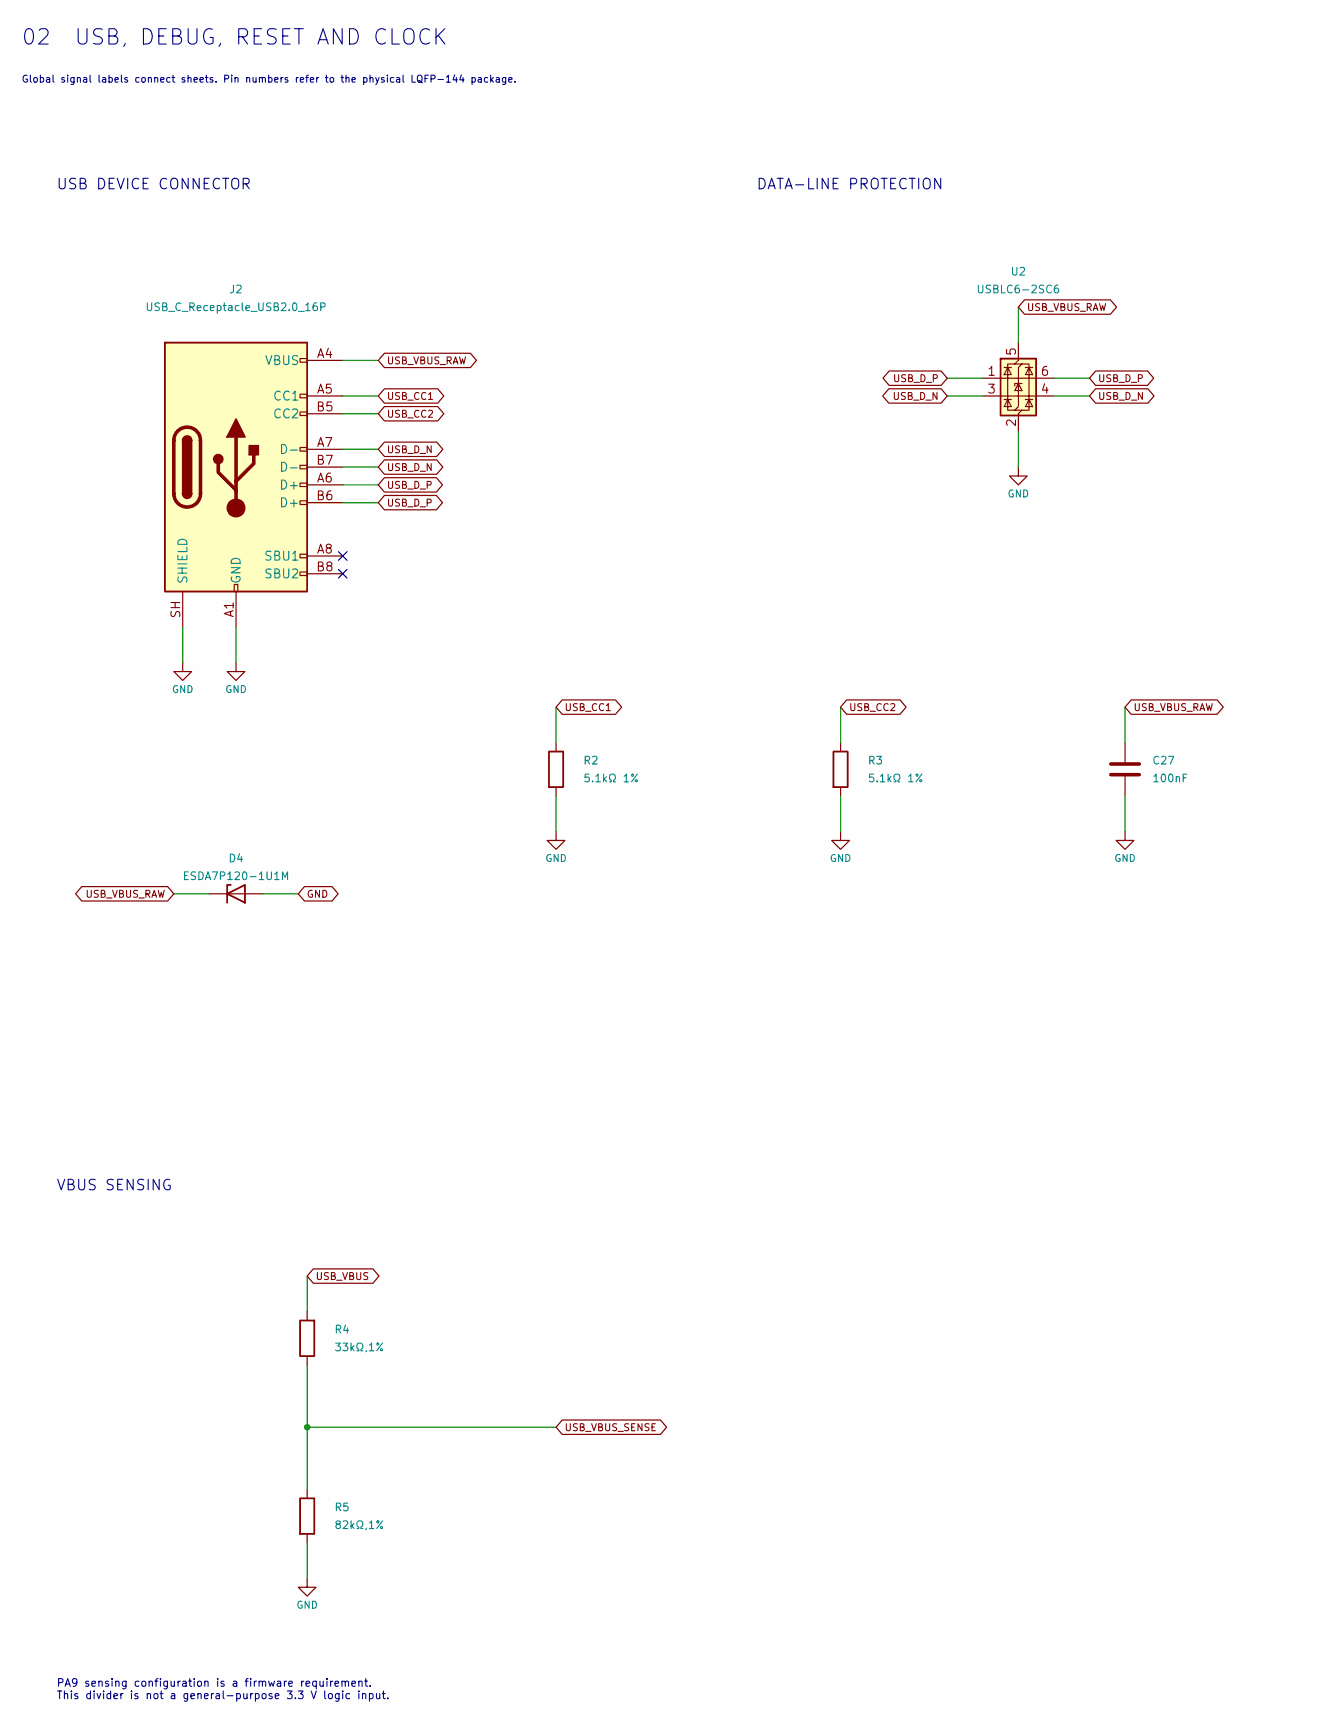
[picture p11: schematic usb_debug_clock.kicad_sch, STM32F446 | USB, debug, reset and clock, part in row 1, column 1]

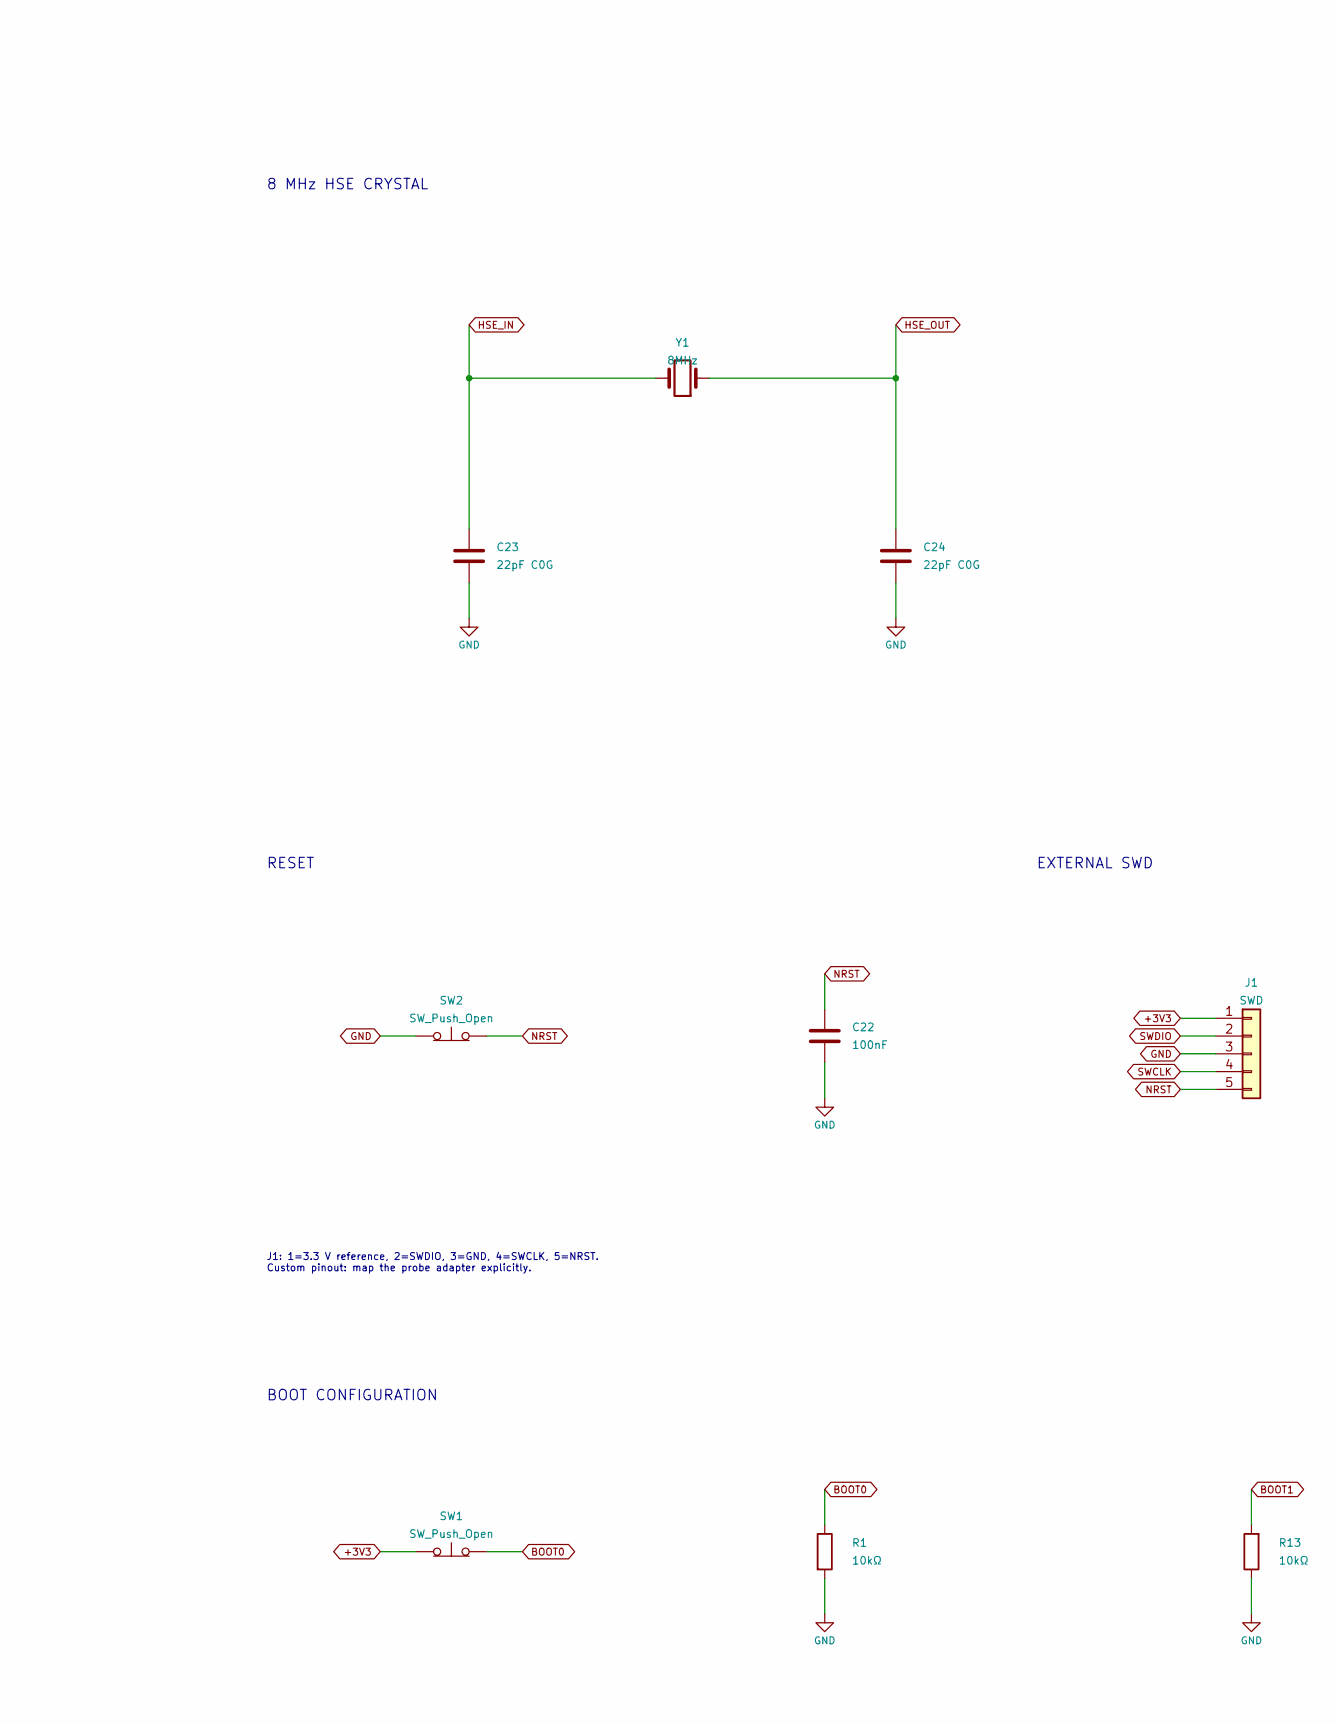
[picture p12: schematic usb_debug_clock.kicad_sch, STM32F446 | USB, debug, reset and clock, part in row 1, column 2]

Parts:
C22, C27: 100nF; C_0805_2012Metric; Manufacturer Part Number CC0805KRX7R9BB104; LCSC Part Number C49678
C23, C24: 22pF C0G; C_0805_2012Metric; Manufacturer Part Number CL21C220JBANNNC; LCSC Part Number C1804
D4: ESDA7P120-1U1M; ESDA7P60-1U1M; Manufacturer Part Number ESDA7P120-1U1M; LCSC Part Number C2969802
J1: SWD; PinHeader_1x05_P2.54mm_Vertical; Manufacturer Part Number SH-PZ254V-1x5P; LCSC Part Number C55629812
J2: USB_C_Receptacle_USB2.0_16P; USB_C_Receptacle_USB4105_JLC; Manufacturer Part Number USB4105-GF-A-120; LCSC Part Number C5184243
R1, R13: 10kΩ; R_0805_2012Metric; Manufacturer Part Number 0805W8F1002T5E; LCSC Part Number C17414
R2, R3: 5.1kΩ 1%; R_0805_2012Metric; Manufacturer Part Number 0805W8F5101T5E; LCSC Part Number C27834
R4: 33kΩ,1%; R_0805_2012Metric; Manufacturer Part Number 0805W8F3302T5E; LCSC Part Number C17633
R5: 82kΩ,1%; R_0805_2012Metric; Manufacturer Part Number 0805W8F8202T5E; LCSC Part Number C17840
SW1, SW2: SW_Push_Open; SW_PUSH_6mm_H4.3mm; Manufacturer Part Number B3F-1000; LCSC Part Number C93157
U2: USBLC6-2SC6; SOT-23-6; Manufacturer Part Number USBLC6-2SC6; LCSC Part Number C7519
Y1: 8MHz; Crystal_SMD_Abracon_ABM3-2Pin_5.0x3.2mm; Manufacturer Part Number ECS-80-18-30-JGN-TR; LCSC Part Number C2450458

Connections:
+3V3: J1.1, SW1.1 (A); also elsewhere on the board
BOOT0: R1.1, SW1.2 (B); also elsewhere on the board
BOOT1: R13.2; also elsewhere on the board
GND: C22.1, C23.2, C24.2, C27.2, D4.2 (A), J1.3, J2.A1 (GND), J2.A12 (GND), J2.B1 (GND), J2.B12 (GND), J2.SH (SHIELD), R1.2, R2.2, R3.2, R5.2, R13.1, SW2.1 (A), U2.2 (GND); also elsewhere on the board
HSE_IN: C23.1, Y1.2; also elsewhere on the board
HSE_OUT: C24.1, Y1.1; also elsewhere on the board
NRST: C22.2, J1.5, SW2.2 (B); also elsewhere on the board
SWCLK: J1.4; also elsewhere on the board
SWDIO: J1.2; also elsewhere on the board
USB_CC1: J2.A5 (CC1), R2.1
USB_CC2: J2.B5 (CC2), R3.1
USB_D_N: J2.A7 (D-), J2.B7 (D-), U2.3 (I/O2), U2.4 (I/O2); also elsewhere on the board
USB_D_P: J2.A6 (D+), J2.B6 (D+), U2.1 (I/O1), U2.6 (I/O1); also elsewhere on the board
USB_VBUS: R4.2; also elsewhere on the board
USB_VBUS_RAW: C27.1, D4.1 (K), J2.A4 (VBUS), J2.A9 (VBUS), J2.B4 (VBUS), J2.B9 (VBUS), U2.5 (VBUS); also elsewhere on the board
USB_VBUS_SENSE: R4.1, R5.1; also elsewhere on the board

Notes on the sheet:
Global signal labels connect sheets. Pin numbers refer to the physical LQFP-144 package.
VBUS SENSING
8 MHz HSE CRYSTAL
EXTERNAL SWD
BOOT CONFIGURATION
USB DEVICE CONNECTOR
J1: 1=3.3 V reference, 2=SWDIO, 3=GND, 4=SWCLK, 5=NRST. Custom pinout: map the probe adapter explicitly.
RESET
02 USB, DEBUG, RESET AND CLOCK
PA9 sensing configuration is a firmware requirement. This divider is not a general-purpose 3.3 V logic input.
DATA-LINE PROTECTION

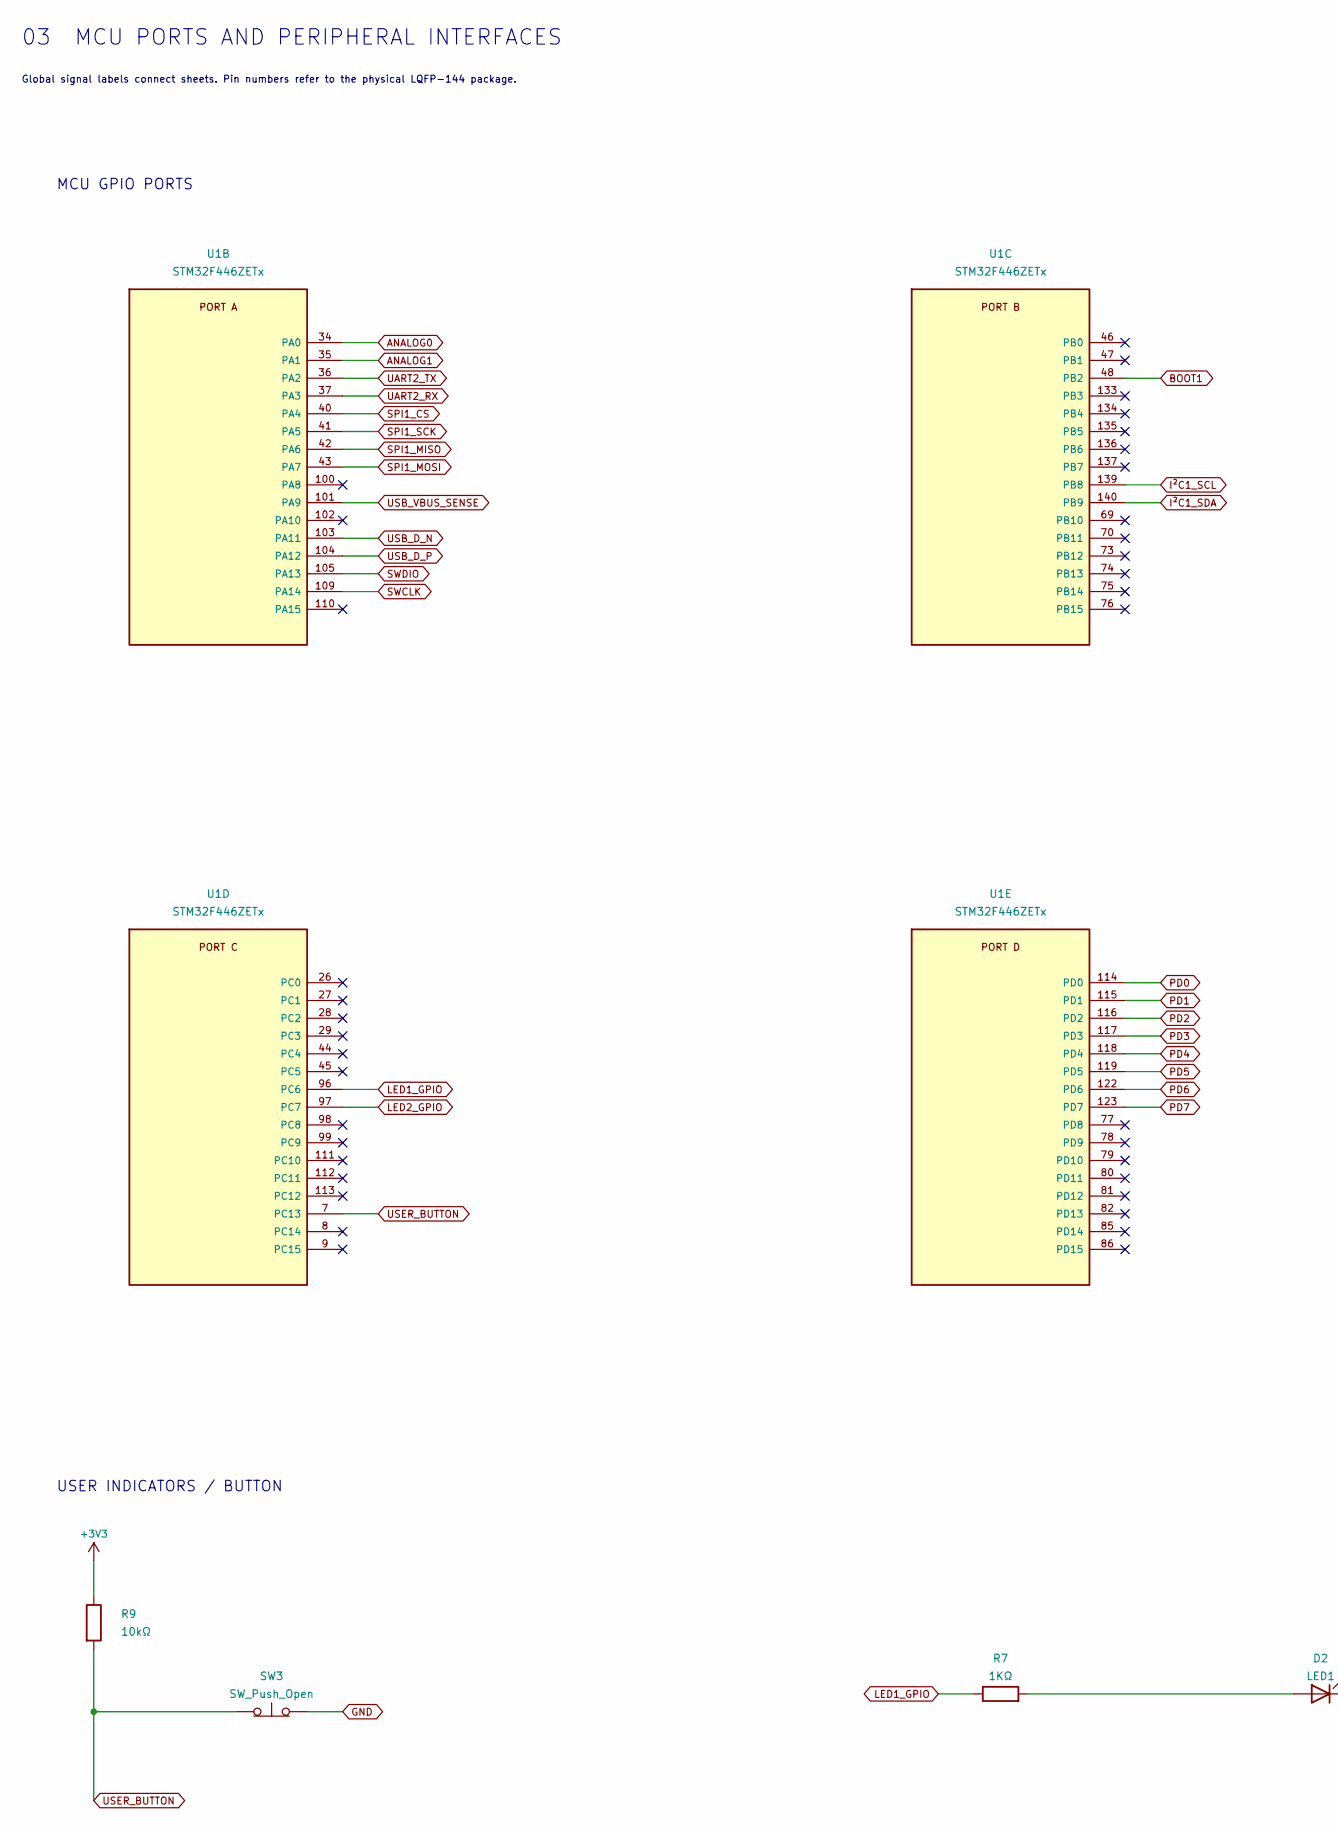
[picture p13: schematic mcu_interfaces.kicad_sch, STM32F446 | MCU ports and peripheral interfaces, part in row 1, column 1]

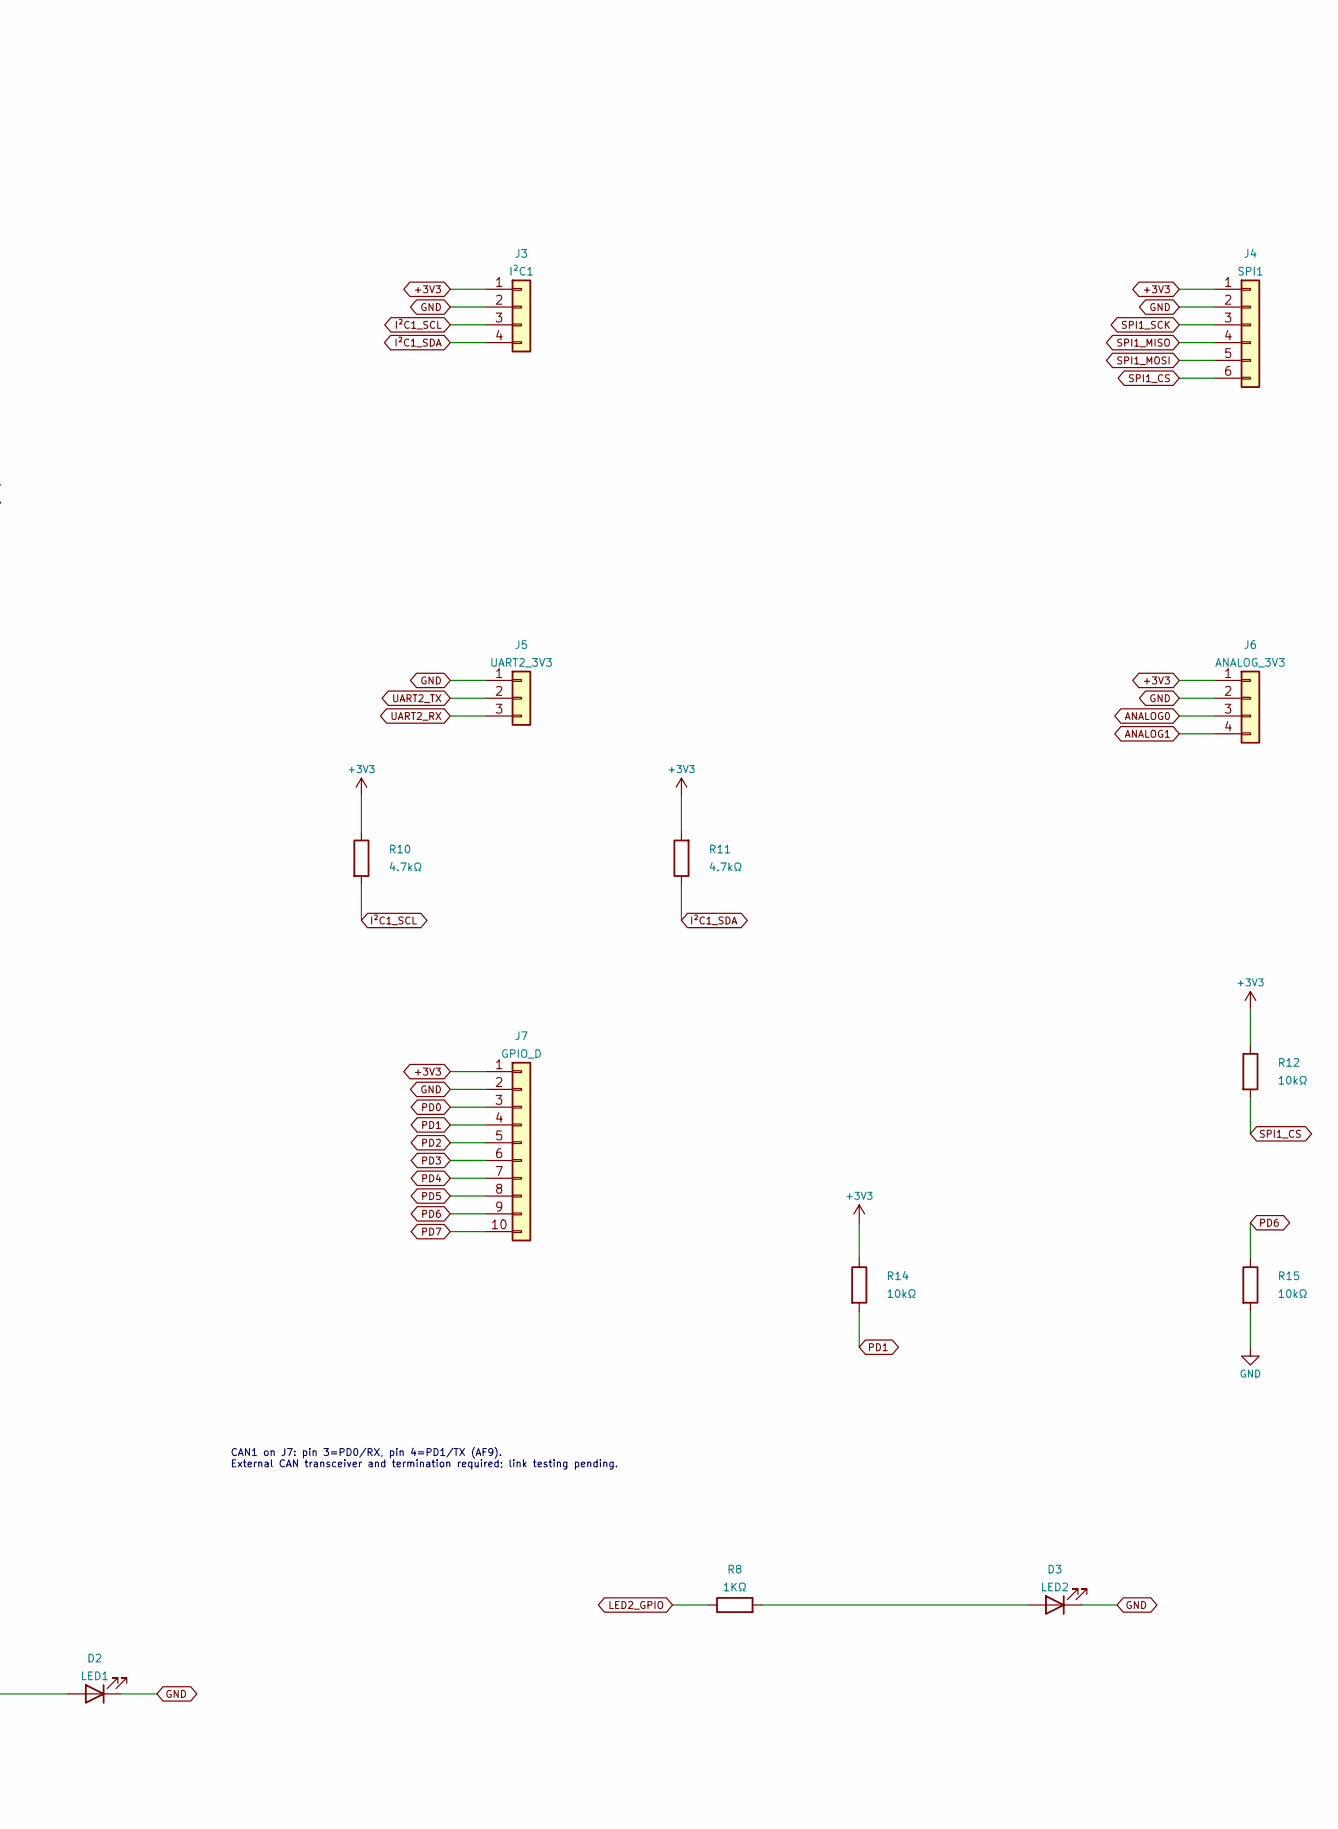
[picture p14: schematic mcu_interfaces.kicad_sch, STM32F446 | MCU ports and peripheral interfaces, part in row 1, column 2]

Parts:
D2: LED1; LED_0805_2012Metric; Manufacturer Part Number KT-0805R; LCSC Part Number C2295
D3: LED2; LED_0805_2012Metric; Manufacturer Part Number KT-0805R; LCSC Part Number C2295
J3: I²C1; PinHeader_1x04_P2.54mm_Vertical; Manufacturer Part Number PZ254V-11-04P; LCSC Part Number C492403
J4: SPI1; PinHeader_1x06_P2.54mm_Vertical; Manufacturer Part Number CS-1109-1*6(L11.5); LCSC Part Number C5142852
J5: UART2_3V3; PinHeader_1x03_P2.54mm_Vertical; Manufacturer Part Number CS-1109-1X3(L11.5)PA6T; LCSC Part Number C18213718
J6: ANALOG_3V3; PinHeader_1x04_P2.54mm_Vertical; Manufacturer Part Number PZ254V-11-04P; LCSC Part Number C492403
J7: GPIO_D; PinHeader_1x10_P2.54mm_Vertical; Manufacturer Part Number PZ254V-11-10P; LCSC Part Number C492409
R7, R8: 1KΩ; R_0805_2012Metric; Manufacturer Part Number 0805W8F1001T5E; LCSC Part Number C17513
R9, R12, R14, R15: 10kΩ; R_0805_2012Metric; Manufacturer Part Number 0805W8F1002T5E; LCSC Part Number C17414
R10, R11: 4.7kΩ; R_0805_2012Metric; Manufacturer Part Number 0805W8F4701T5E; LCSC Part Number C17673
SW3: SW_Push_Open; SW_PUSH_6mm_H4.3mm; Manufacturer Part Number B3F-1000; LCSC Part Number C93157
U1: STM32F446ZETx; LQFP-144_20x20mm_P0.5mm; Manufacturer Part Number STM32F446ZET6; LCSC Part Number C1337227

Connections:
+3V3: J3.1, J4.1, J6.1, J7.1, R9.1, R10.1, R11.2, R12.1, R14.1; also elsewhere on the board
ANALOG0: J6.3, U1.34 (PA0)
ANALOG1: J6.4, U1.35 (PA1)
BOOT1: U1.48 (PB2); also elsewhere on the board
GND: D2.1 (K), D3.1 (K), J3.2, J4.2, J5.1, J6.2, J7.2, R15.2, SW3.2 (B); also elsewhere on the board
I²C1_SCL: J3.3, R10.2, U1.139 (PB8)
I²C1_SDA: J3.4, R11.1, U1.140 (PB9)
LED1_GPIO: R7.1, U1.96 (PC6)
LED2_GPIO: R8.1, U1.97 (PC7)
unnamed: D2.2 (A), R7.2
unnamed: D3.2 (A), R8.2
PD0: J7.3, U1.114 (PD0)
PD1: J7.4, R14.2, U1.115 (PD1)
PD2: J7.5, U1.116 (PD2)
PD3: J7.6, U1.117 (PD3)
PD4: J7.7, U1.118 (PD4)
PD5: J7.8, U1.119 (PD5)
PD6: J7.9, R15.1, U1.122 (PD6)
PD7: J7.10, U1.123 (PD7)
SPI1_CS: J4.6, R12.2, U1.40 (PA4)
SPI1_MISO: J4.4, U1.42 (PA6)
SPI1_MOSI: J4.5, U1.43 (PA7)
SPI1_SCK: J4.3, U1.41 (PA5)
SWCLK: U1.109 (PA14); also elsewhere on the board
SWDIO: U1.105 (PA13); also elsewhere on the board
UART2_RX: J5.3, U1.37 (PA3)
UART2_TX: J5.2, U1.36 (PA2)
USB_D_N: U1.103 (PA11); also elsewhere on the board
USB_D_P: U1.104 (PA12); also elsewhere on the board
USB_VBUS_SENSE: U1.101 (PA9); also elsewhere on the board
USER_BUTTON: R9.2, SW3.1 (A), U1.7 (PC13)

Notes on the sheet:
USER INDICATORS / BUTTON
CAN1 on J7: pin 3=PD0/RX, pin 4=PD1/TX (AF9). External CAN transceiver and termination required; link testing pending.
Global signal labels connect sheets. Pin numbers refer to the physical LQFP-144 package.
MCU GPIO PORTS
03 MCU PORTS AND PERIPHERAL INTERFACES
