ackom-a-o/stm32f446-development-board/stm32.kicad_pcb

## KiCad design stm32.kicad_pcb (continued)

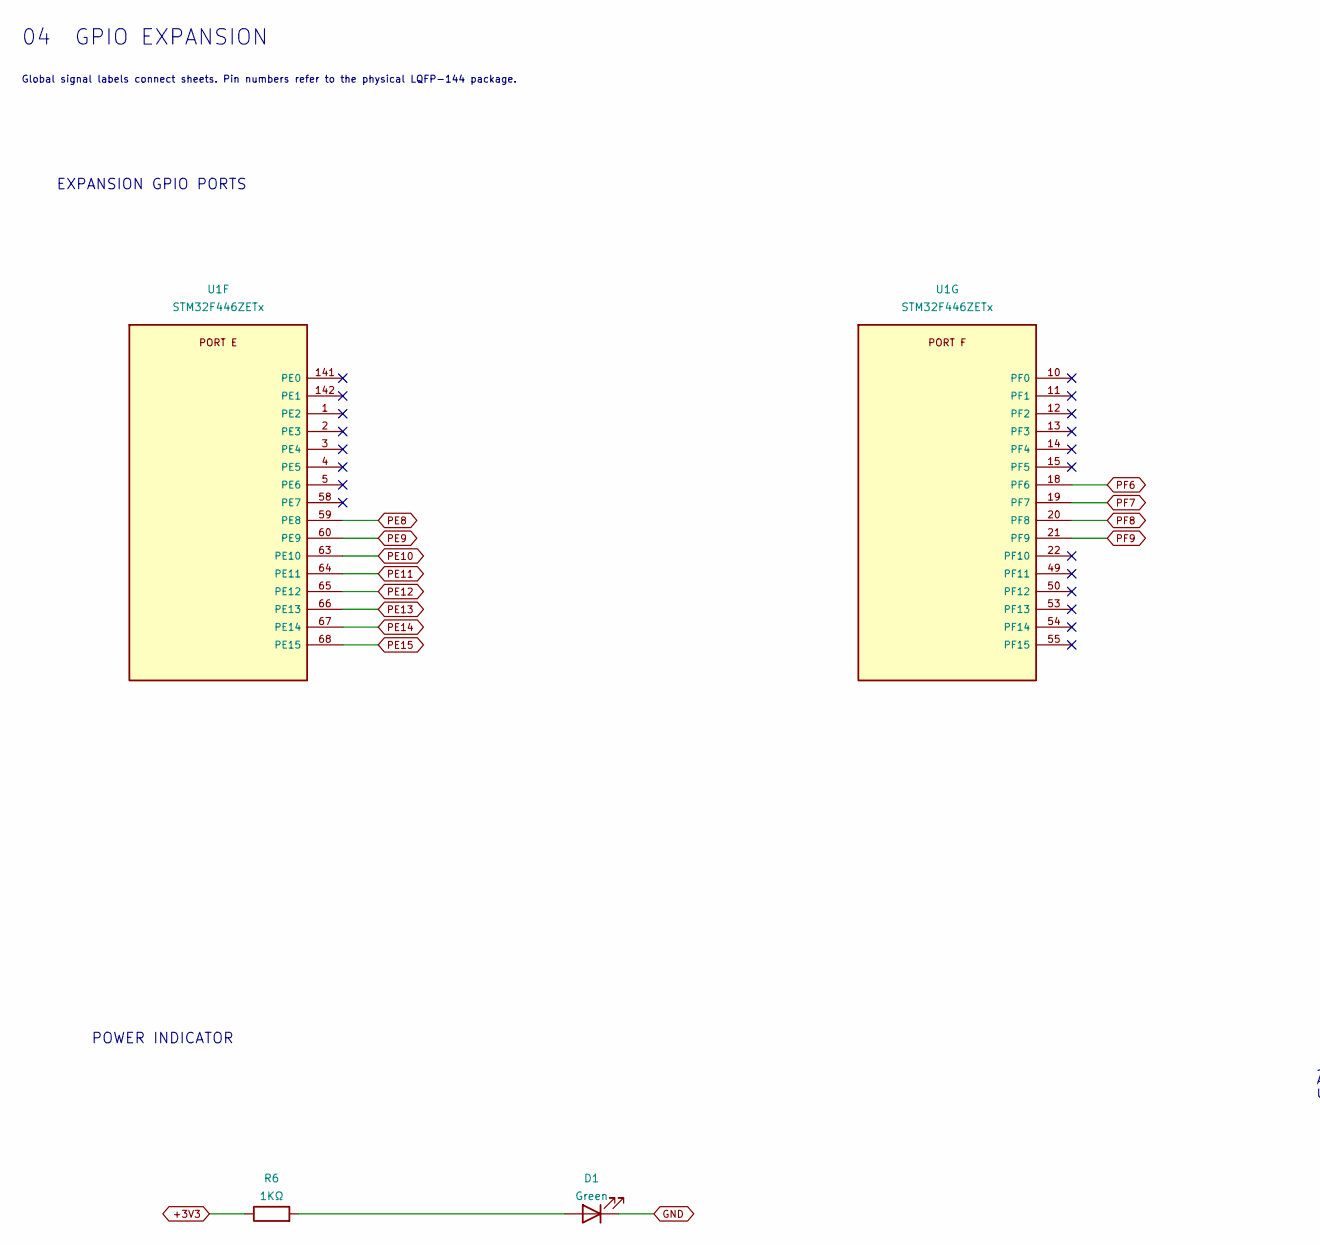
[picture p15: schematic gpio_expansion.kicad_sch, STM32F446 | GPIO expansion, part in row 1, column 1]

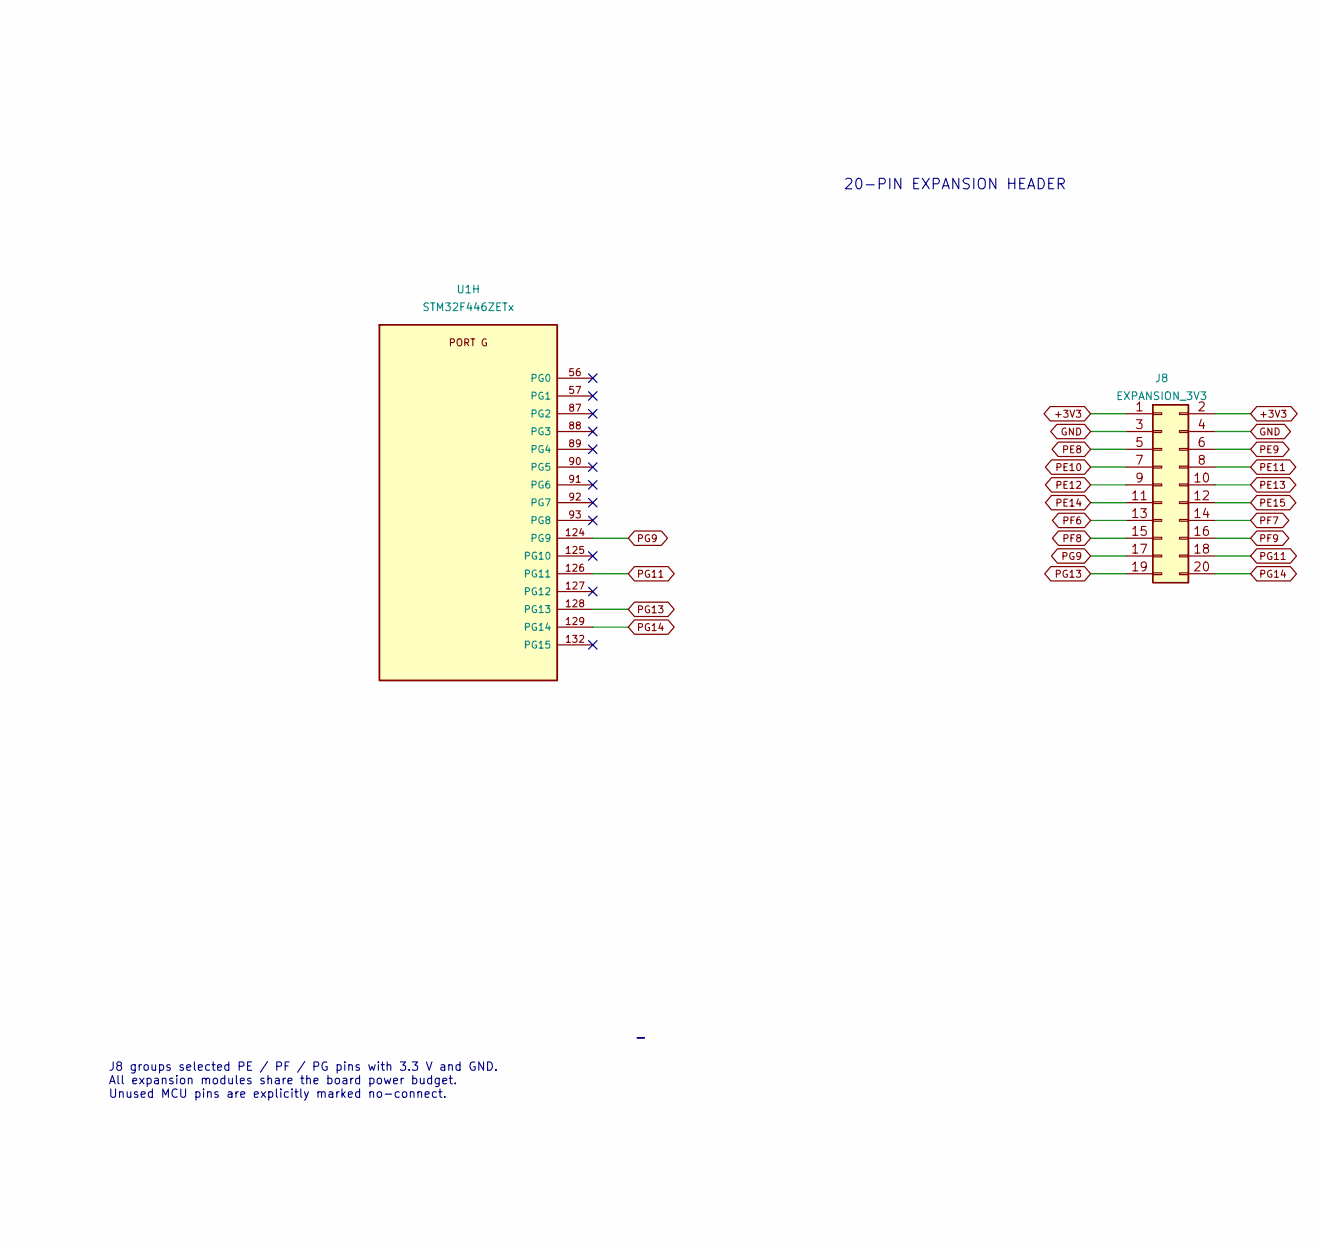
[picture p16: schematic gpio_expansion.kicad_sch, STM32F446 | GPIO expansion, part in row 1, column 2]

Parts:
D1: Green; LED_0805_2012Metric; Manufacturer Part Number KT-0805G; LCSC Part Number C2297
J8: EXPANSION_3V3; PinHeader_2x10_P2.54mm_Vertical; Manufacturer Part Number PZ254V-12-20P; LCSC Part Number C492427
R6: 1KΩ; R_0805_2012Metric; Manufacturer Part Number 0805W8F1001T5E; LCSC Part Number C17513
U1: STM32F446ZETx; LQFP-144_20x20mm_P0.5mm; Manufacturer Part Number STM32F446ZET6; LCSC Part Number C1337227

Connections:
+3V3: J8.1, J8.2, R6.1; also elsewhere on the board
GND: D1.1 (K), J8.3, J8.4; also elsewhere on the board
unnamed: D1.2 (A), R6.2
PE8: J8.5, U1.59 (PE8)
PE9: J8.6, U1.60 (PE9)
PE10: J8.7, U1.63 (PE10)
PE11: J8.8, U1.64 (PE11)
PE12: J8.9, U1.65 (PE12)
PE13: J8.10, U1.66 (PE13)
PE14: J8.11, U1.67 (PE14)
PE15: J8.12, U1.68 (PE15)
PF6: J8.13, U1.18 (PF6)
PF7: J8.14, U1.19 (PF7)
PF8: J8.15, U1.20 (PF8)
PF9: J8.16, U1.21 (PF9)
PG9: J8.17, U1.124 (PG9)
PG11: J8.18, U1.126 (PG11)
PG13: J8.19, U1.128 (PG13)
PG14: J8.20, U1.129 (PG14)

Notes on the sheet:
20-PIN EXPANSION HEADER
POWER INDICATOR
Global signal labels connect sheets. Pin numbers refer to the physical LQFP-144 package.
04 GPIO EXPANSION
EXPANSION GPIO PORTS
J8 groups selected PE / PF / PG pins with 3.3 V and GND. All expansion modules share the board power budget. Unused MCU pins are explicitly marked no-connect.

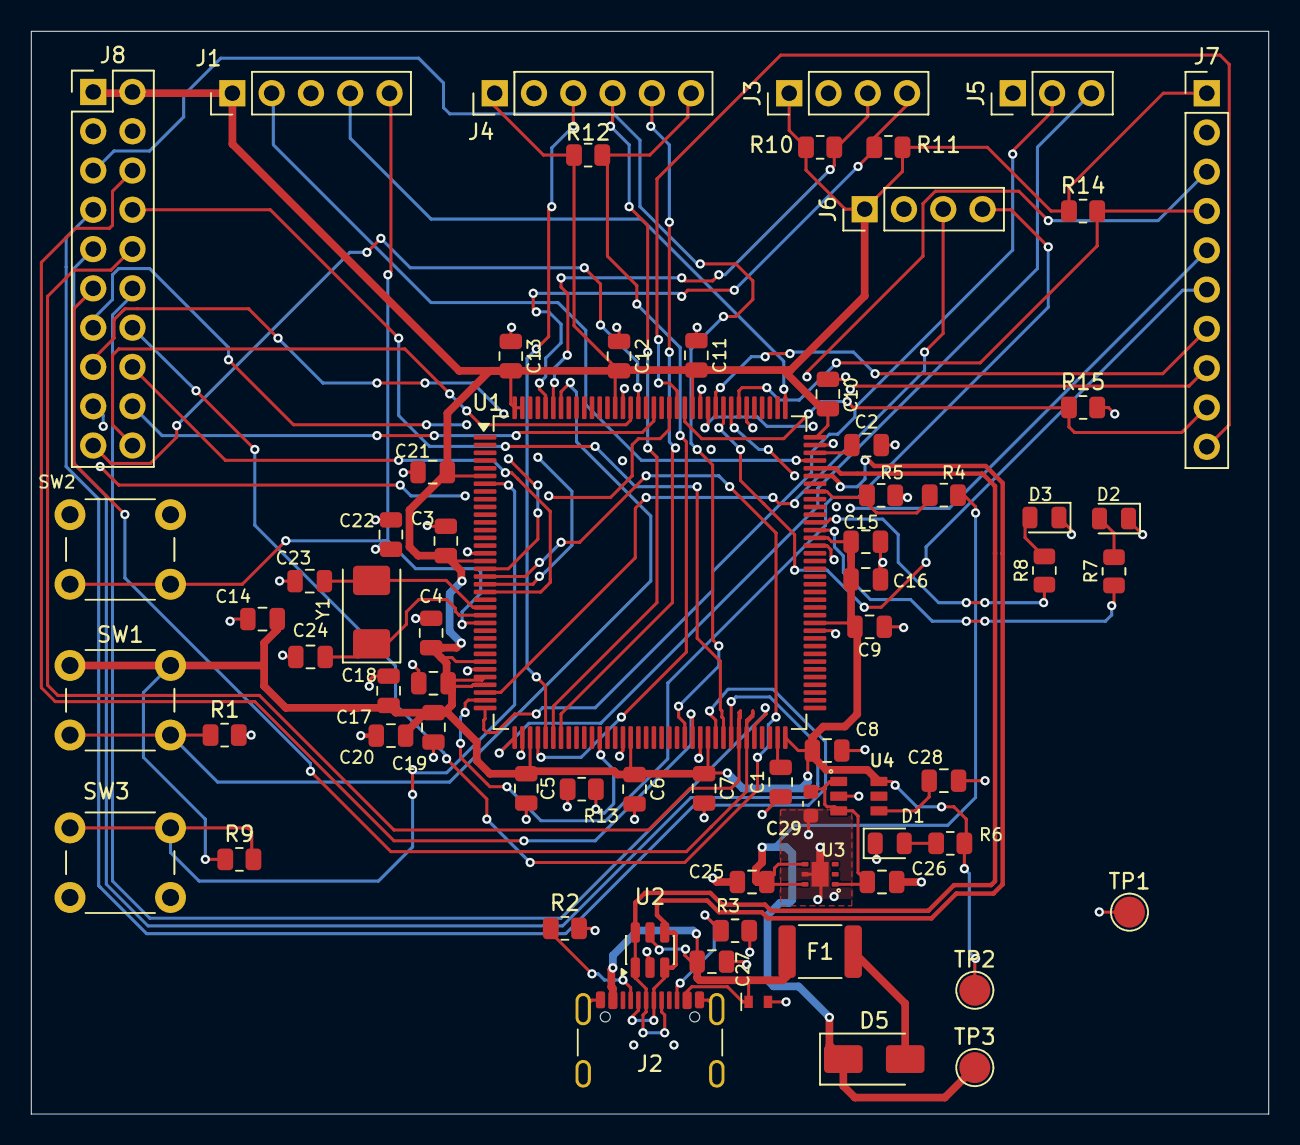
[picture p17: board stm32.kicad_pcb from above]

Board: 4 copper layers, 80.0 x 70.0 mm, 69 parts (0 on the bottom side), 61 nets.
