ackom-a-o/stm32f446-development-board/(commit log)

2026-10-16 Document STM32F446 prototype hardware and validation plan
    [stm32.kicad_pcb, stm32.kicad_sch]
2026-10-16 Add design visuals, engineering decisions and traceable review evidence
2026-10-16 Organize schematic into functional sheets with verified pin mapping
    [gpio_expansion.kicad_sch, mcu_interfaces.kicad_sch, schematic-refactor.json, stm32.kicad_pcb, stm32.kicad_sch, usb_debug_clock.kicad_sch]
2026-10-22 Publish corrected prototype package and documented engineering review
    [BOM.csv, gpio_expansion.kicad_sch, stm32.kicad_pcb, stm32.kicad_sch, usb_debug_clock.kicad_sch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]
